smartuni/riot-po-2026/server/frontend/docs/README.md

# SenseMate Frontend

> **Reliable IoT (RIOT) Team — PO-2026**  
> A university project for intelligent flood disaster management

Welcome to the frontend documentation for **SenseMate**, the dashboard and control interface for an IoT-based flood gate management system. This documentation covers the architecture, technology choices, data flows, and design decisions of the React application.

## Quick Links

- [Project Overview](overview.md)
- [Tech Stack](techstack.md)
- [Architecture](architecture.md)
- [Pages & Routing](routing.md)
- [Authentication Flow](authentication.md)
- [Real-Time Communication](real-time.md)
- [Data Flow Patterns](data-flow.md)
- [Build & Deployment](deployment.md)
- [Developer Snippets](snippets.md)
