smartuni/riot-po-2026/nodes/firmware/applications/senseGate/README.md

# SenseGate

### Description
This Module provides the SenseGate Application which detects the status (open/close) of a flood gate. 

### Startup and operation

Pins:
Sensor needs to be connected to: Grnd / A5

- Connect to Power
- Wait until blue LED is on
- Red LED indicates if door is open (LED off) or closed (LED on)
- Blue LED indicates, if a state update is in progress (LED off). 
- There is a time runoff, which is triggered/restarted on any sensor input. When blue LED is on, the update is processed and sent via LoraWAN.    

### Deployment

After flashing, use the [identity-manager](../../identity-manager/README.md) to generate a node identity and provision it to the node.

#### Building and Flashing

```make all flash```
