smartuni/riot-po-2026/nodes/hardware/SenseMate/SenseMatePCB/SenseMate_v2/Parts_Material/SenseMate_Infos.txt

Seeed Studio XIAO nRF52840 Sense Plus
-> Sensoren
https://wiki.seeedstudio.com/XIAO_BLE/
https://www.seeedstudio.com/Seeed-Studio-XIAO-nRF52840-Sense-Plus-p-6360.html

LoRa1276-C1-915
https://www.nicerf.com/lora-module/sx1276-lora-module-lora1276-c1.html

-> https://www.snapeda.com/parts/RFM95W-868S2/RF%20Solutions/view-part/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

-

https://www.lcsc.com/product-detail/C7279189.html
