smartuni/riot-po-2026/documentation/material/Backend-View.png

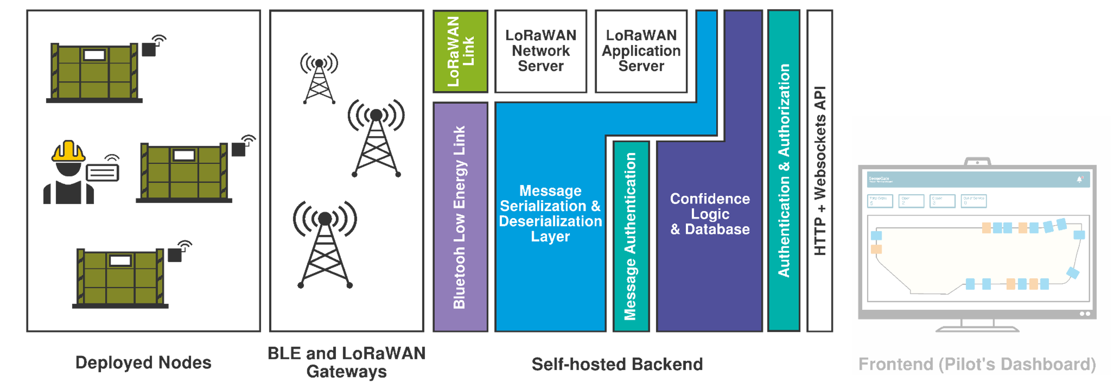
documentation/material/Backend-View.png
