smartuni/riot-po-2026/documentation/material/businesscontextView.png

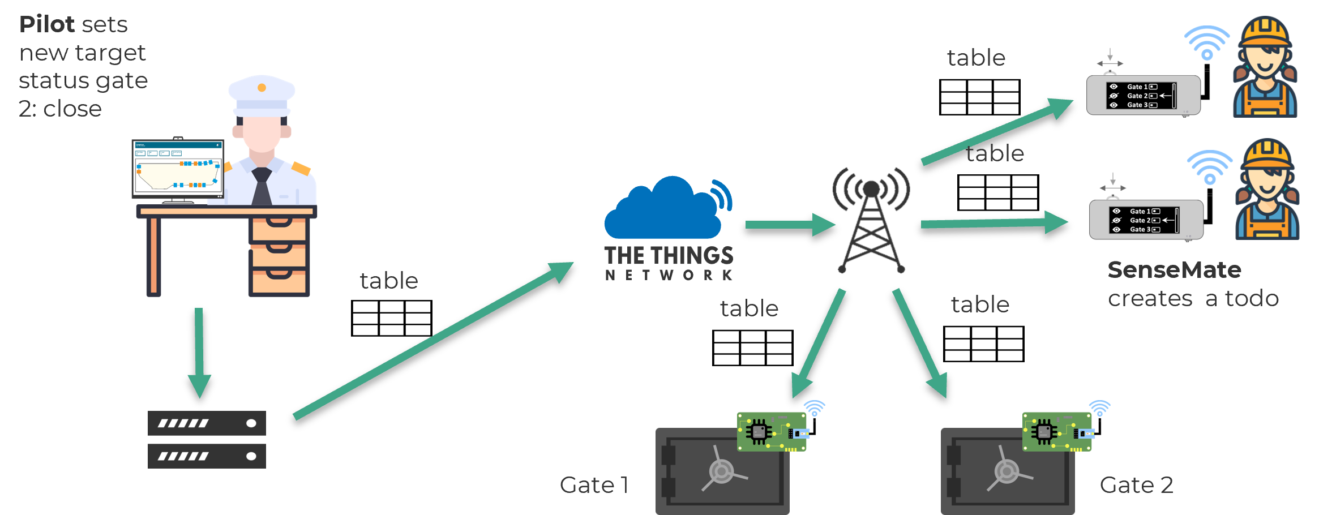
documentation/material/businesscontextView.png
