smartuni/riot-po-2026/documentation/material/technicalView-keys.png

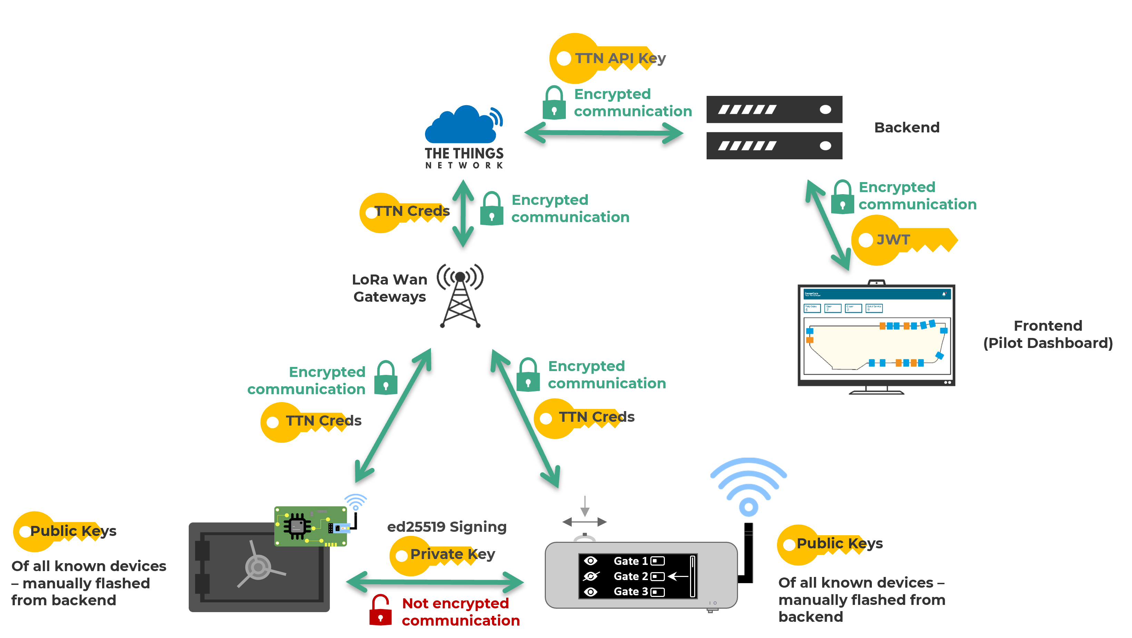
documentation/material/technicalView-keys.png
