smartuni/riot-po-2026/documentation/material/technicalView.png

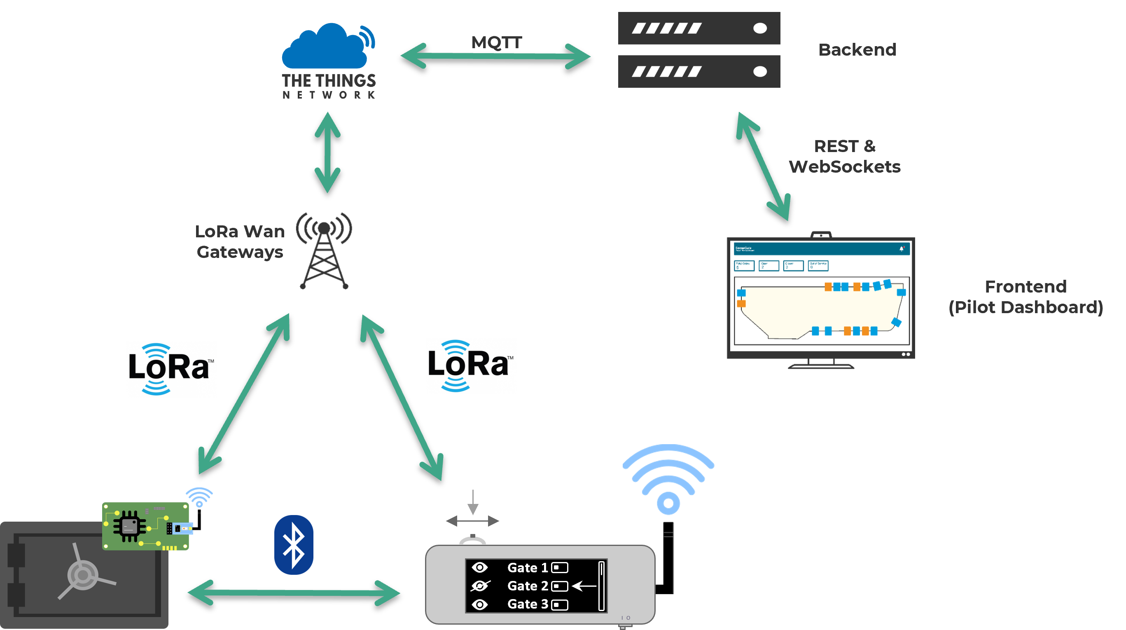
documentation/material/technicalView.png
