smartuni/riot-po-2026/nodes/hardware/SenseMate/SenseMatePCB/SenseMate_v2/Parts_Material/Material_LoRa127X-C1/2412211KGQJ.webp

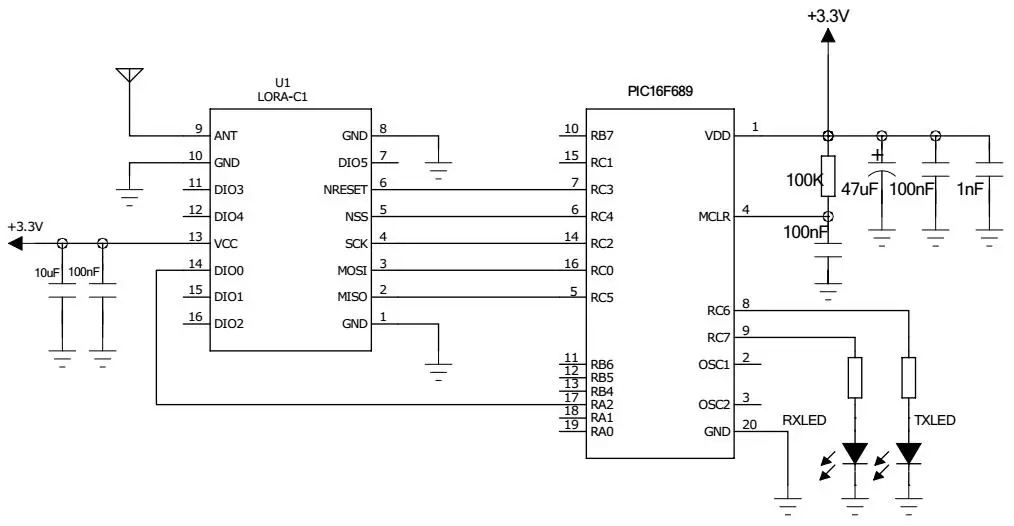
nodes/hardware/SenseMate/SenseMatePCB/SenseMate_v2/Parts_Material/Material_LoRa127X-C1/2412211KGQJ.webp
