smartuni/riot-po-2026/nodes/hardware/SenseMate/SenseMatePCB/SenseMate_v2/Parts_Material/Material_nRF52840SensePlus/4-102010694-seeedstudio-xiao-nrf52840-sense-plus-back_1.jpg

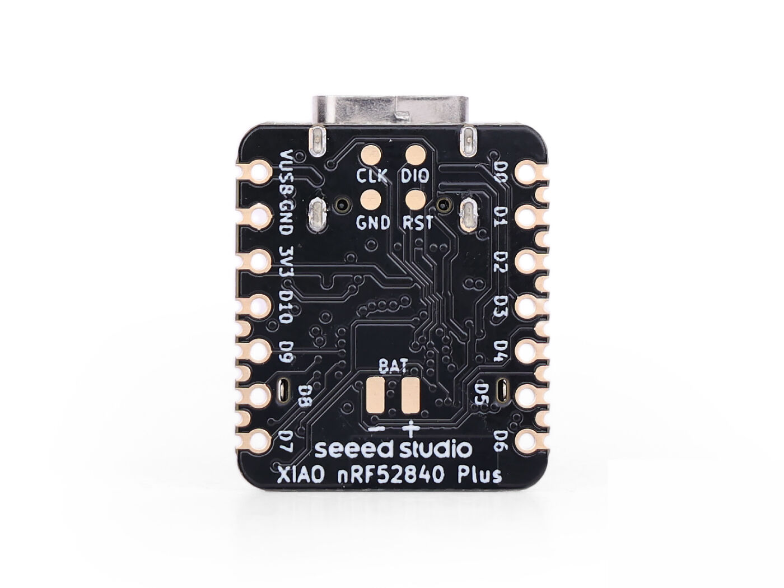
nodes/hardware/SenseMate/SenseMatePCB/SenseMate_v2/Parts_Material/Material_nRF52840SensePlus/4-102010694-seeedstudio-xiao-nrf52840-sense-plus-back_1.jpg
