smartuni/riot-po-2026/nodes/hardware/SenseMate/SenseMatePCB/SenseMate_v2/Parts_Material/Material_nRF52840SensePlus/plus_front.png

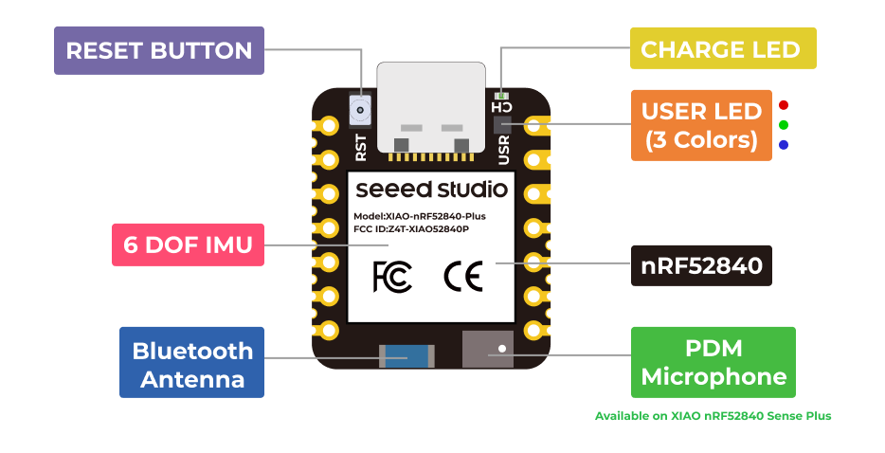
nodes/hardware/SenseMate/SenseMatePCB/SenseMate_v2/Parts_Material/Material_nRF52840SensePlus/plus_front.png
