smartuni/riot-po-2026/nodes/hardware/SenseMate/SenseMatePCB/SenseMate_v2/3dshapes/seeeduino-xiao-samd21-v4.step

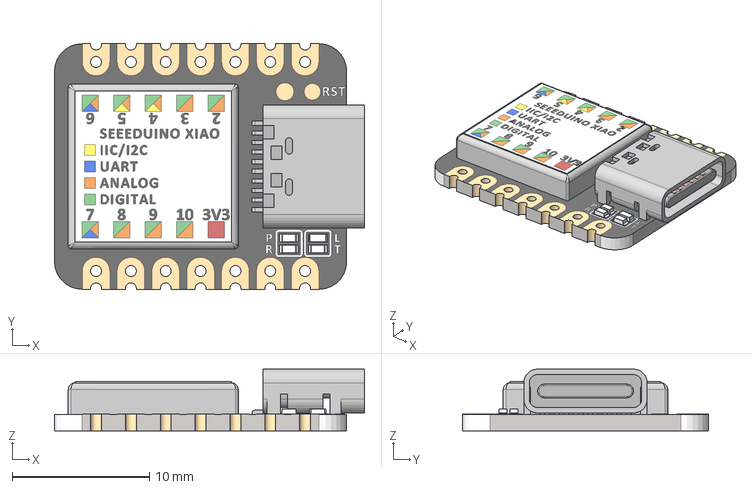
[picture p13: CAD file, 2026-07-06]
nodes/hardware/SenseMate/SenseMatePCB/SenseMate_v2/3dshapes/seeeduino-xiao-samd21-v4.step
22.6 x 17.9 x 4.51 mm
