smartuni/riot-po-2026/nodes/hardware/SenseMate/SenseMatePCB/SenseMate_v2/3dshapes/NAV_SWITCH_separate_colors.STEP

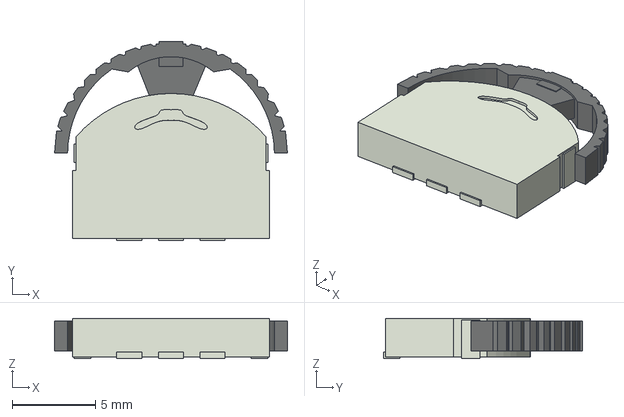
[picture p15: CAD file, 2025-11-07]
nodes/hardware/SenseMate/SenseMatePCB/SenseMate_v2/3dshapes/NAV_SWITCH_separate_colors.STEP
14.0 x 11.9 x 2.40 mm
