smartuni/riot-po-2026/nodes/hardware/SenseMate/SenseMatePCB/SenseMate_v2/3dshapes/4516 Feather nRF52840 Sense_FC_exp.step

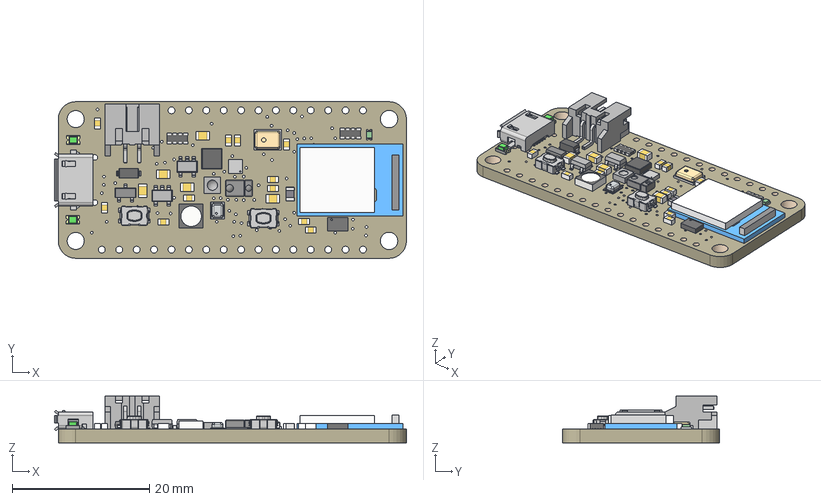
[picture p16: CAD file, 2025-11-07]
nodes/hardware/SenseMate/SenseMatePCB/SenseMate_v2/3dshapes/4516 Feather nRF52840 Sense_FC_exp.step
51.4 x 22.9 x 6.79 mm
JSTPH2
BMP280
SPK0415HM4H
LGA12_2X2MM
LGA16_3X3MM
RESPACK_4X0603 x 2
0805-NO x 5
0603-NO x 11
LED3535
USON8
MDBT50
CHIPLED_0603_NOOUTLINE
_0805MP
SHT3X
SOT23-R
SOD-123
4UCONN_20329_V2
CHIPLED_0805_NOOUTLINE x 2
APDS-9960
SOT23-5 x 2
BTN_KMR2_4.6X2.8 x 2
Board
