smartuni/riot-po-2026/nodes/hardware/SenseMate/SenseMatePCB/SenseMate_v2/3dshapes/3229 Radio FeatherWing.step

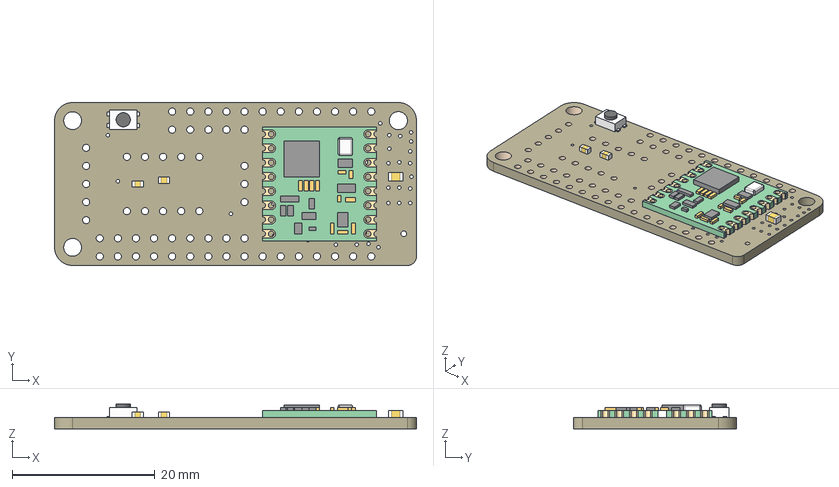
[picture p17: CAD file, 2025-11-07]
nodes/hardware/SenseMate/SenseMatePCB/SenseMate_v2/3dshapes/3229 Radio FeatherWing.step
50.8 x 22.9 x 3.47 mm
Board
BTN_KMR2_4.6X2.8
10uF
RFM69/9x
100k x 2
