smartuni/riot-po-2026/nodes/hardware/SenseMate/SenseMatePCB/SenseMate_v2/3dshapes/SSD1306_OLED_Display(128x64)_trimmed_legs.step

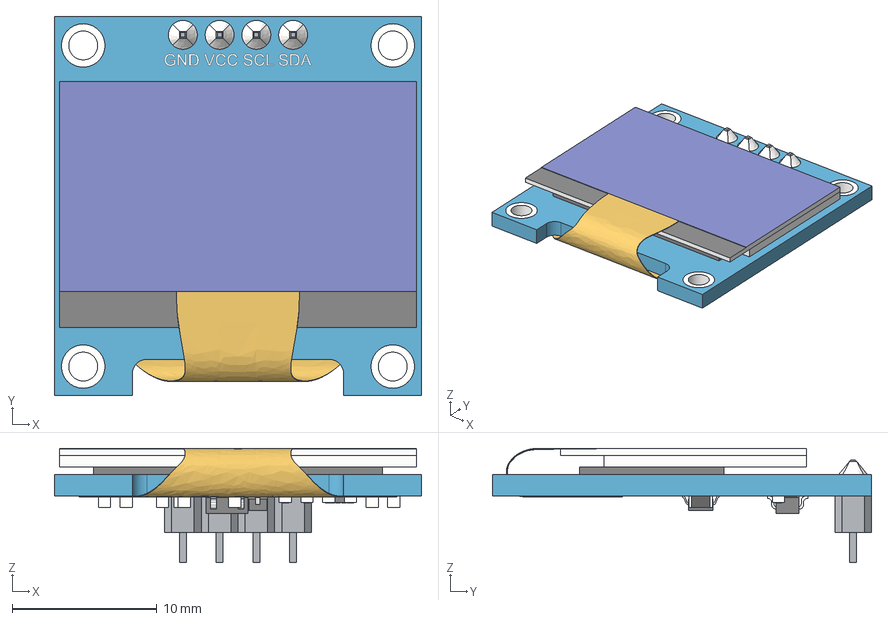
[picture p18: CAD file, 2025-11-07]
nodes/hardware/SenseMate/SenseMatePCB/SenseMate_v2/3dshapes/SSD1306_OLED_Display(128x64)_trimmed_legs.step
25.4 x 26.2 x 7.90 mm
board
board001
board002
board003
board004
board005
board006
board007
board008
screen
screen001
screen002
soldering
soldering001
soldering002
soldering003
smd_capacitor
smd_capacitor001
smd_capacitor002
smd_capacitor (1)
smd_capacitor (1)001
smd_capacitor (1)002
914_smd_resistor
914_smd_resistor001
914_smd_resistor002
472_smd_resistor x 3
472_smd_resistor001 x 3
472_smd_resistor002 x 3
t4_smd_diode
t4_smd_diode001
t4_smd_diode002
smd_capacitor (2)
smd_capacitor (2)001
smd_capacitor (2)002
smd_capacitor (3)
smd_capacitor (3)001
smd_capacitor (3)002
smd_capacitor (4)
smd_capacitor (4)001
smd_capacitor (4)002
smd_capacitor (5)
smd_capacitor (5)001
smd_capacitor (5)002
smd_capacitor (6)
smd_capacitor (6)001
smd_capacitor (6)002
472_smd_resistor (1)
472_smd_resistor (1)001
472_smd_resistor (1)002
SOT-23_XC6206 v3
SOT-23_XC6206 v004
SOT-23_XC6206 v005
SOT-23_XC6206 v006
smd_capacitor (7)
smd_capacitor (7)001
smd_capacitor (7)002
flat_cable
