smartuni/riot-po-2026/nodes/hardware/SenseMate/SenseMatePCB/SenseMate_v2/3dshapes/16-Pin Header - Female - 2.54mm.step

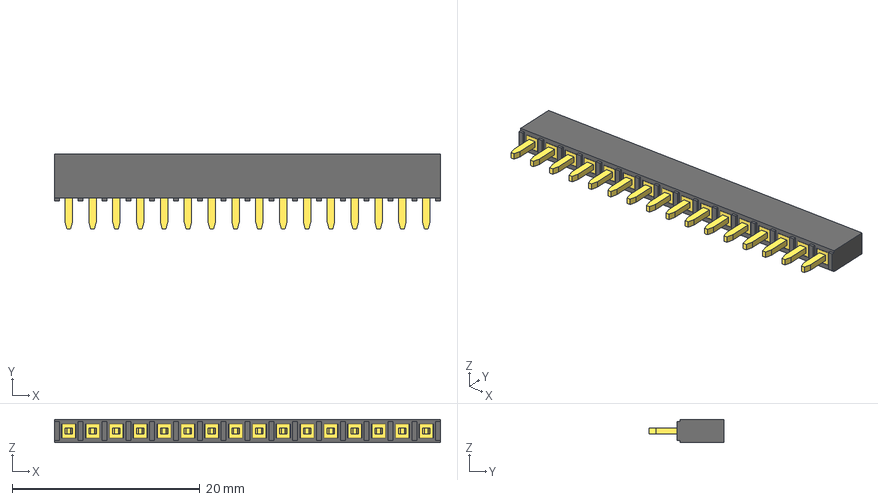
[picture p19: CAD file, 2025-11-07]
nodes/hardware/SenseMate/SenseMatePCB/SenseMate_v2/3dshapes/16-Pin Header - Female - 2.54mm.step
41.1 x 8.00 x 2.50 mm
