smartuni/riot-po-2026/nodes/hardware/SenseMate/SenseMatePCB/SenseMate_v2/3dshapes/12-Pin Header - Female - 2.54mm.step

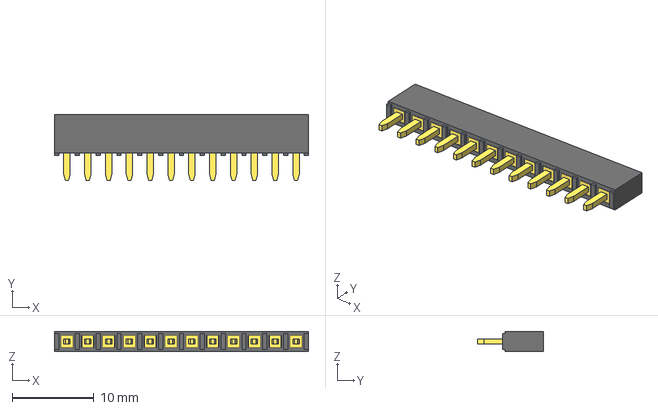
[picture p20: CAD file, 2025-11-07]
nodes/hardware/SenseMate/SenseMatePCB/SenseMate_v2/3dshapes/12-Pin Header - Female - 2.54mm.step
31.0 x 8.00 x 2.50 mm
