smartuni/riot-po-2026/nodes/hardware/SenseMate/SenseMatePCB/SenseMate_v2/3dshapes/PS1240P02BT005_trimmed_legs.step

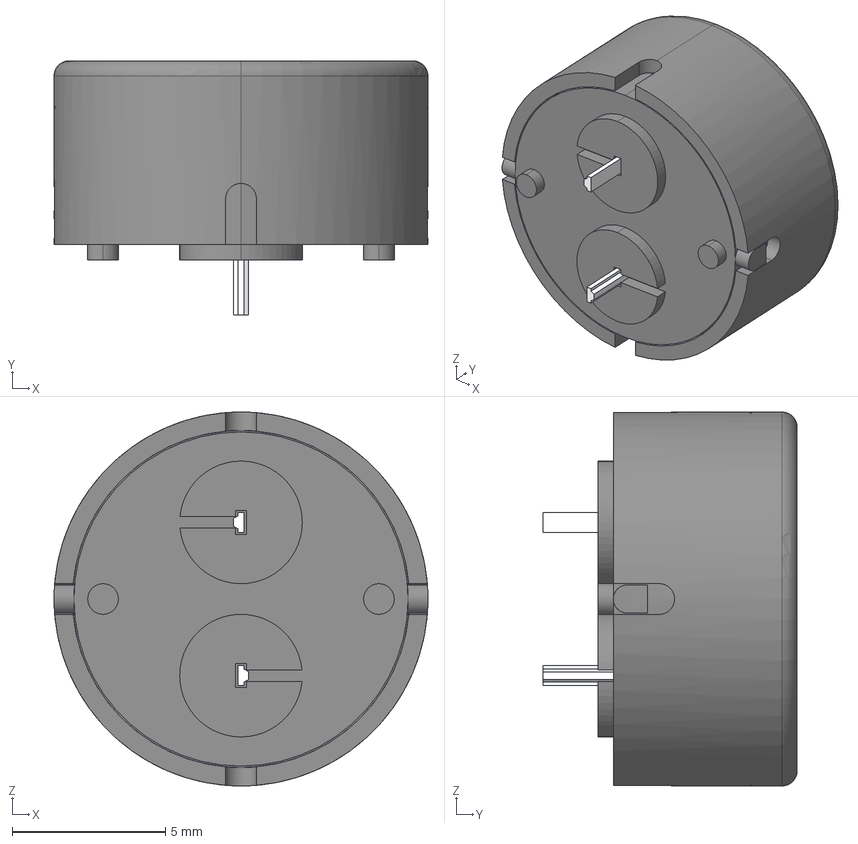
[picture p22: CAD file, 2025-11-07]
nodes/hardware/SenseMate/SenseMatePCB/SenseMate_v2/3dshapes/PS1240P02BT005_trimmed_legs.step
12.2 x 8.30 x 12.2 mm
PS1240P02BT
PS1240P02BT001
PS1240P02BT004
