smartuni/riot-po-2026/nodes/hardware/SenseMate/SenseMatePCB/SenseMate_v2/3dshapes/PS1240P02BT.STEP

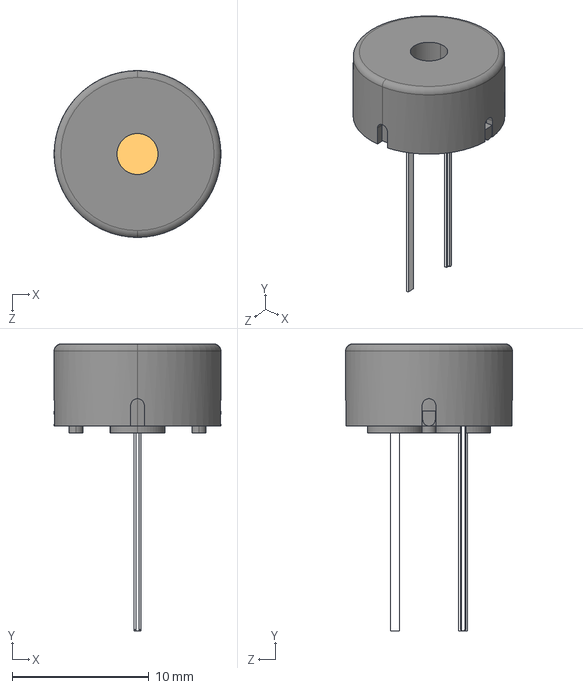
[picture p23: CAD file, 2025-11-07]
nodes/hardware/SenseMate/SenseMatePCB/SenseMate_v2/3dshapes/PS1240P02BT.STEP
12.2 x 21.0 x 12.2 mm
