smartuni/riot-po-2026/nodes/hardware/SenseMate/SenseMatePCB/SenseMate_v2/3dshapes/OS102011MA1QN1.STEP

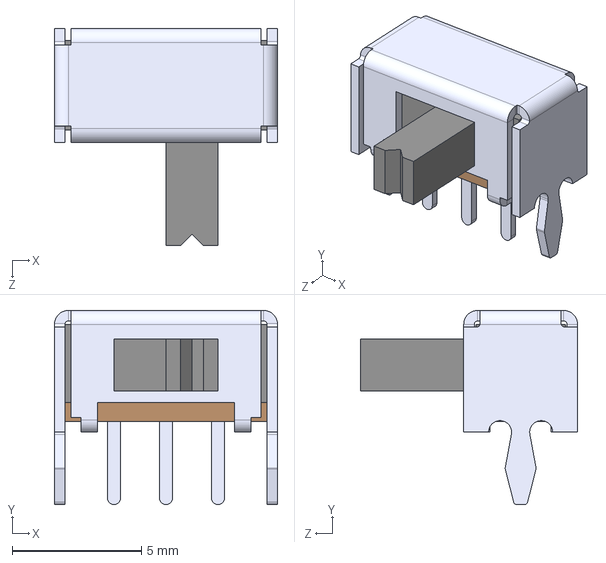
[picture p24: CAD file, 2025-11-07]
nodes/hardware/SenseMate/SenseMatePCB/SenseMate_v2/3dshapes/OS102011MA1QN1.STEP
8.61 x 7.49 x 8.38 mm
