smartuni/riot-po-2026/(list of files, cad)

Other CAD files:
nodes/hardware/SenseMate/SenseMatePCB/SenseMate_v2/3dshapes/NAV_SWITCH_FC_edit-Part.step
nodes/hardware/SenseMate/SenseMatePCB/SenseMate_v2/3dshapes/NAV_SWITCH.STEP
nodes/hardware/SenseMate/SenseMatePCB/SenseMate_v2/3dshapes/4516 Feather nRF52840 Sense.step
nodes/hardware/SenseMate/SenseMatePCB/SenseMate_v1/3dshapes/4516 Feather nRF52840 Sense.step
nodes/hardware/SenseMate/SenseMatePCB/SenseMate_v1/3dshapes/4516 Feather nRF52840 Sense_FC_exp.stl
nodes/hardware/SenseMate/SenseMatePCB/SenseMate_v1/3dshapes/4516_Feather_nRF52840_Sense.step
nodes/hardware/SenseMate/SenseMatePCB/SenseMate_v1/3dshapes/NAV_SWITCH.STEP
nodes/hardware/SenseMate/SenseMatePCB/SenseMate_v1/3dshapes/NAV_SWITCH_FC_edit-Part.step
nodes/hardware/SenseMate/SenseMatePCB/SenseMate_v2/3dshapes/4516 Feather nRF52840 Sense_FC_exp.stl
nodes/hardware/SenseMate/SenseMatePCB/SenseMate_v2/3dshapes/4516_Feather_nRF52840_Sense.step
