smartuni/riot-po-2026/nodes/hardware/SenseGate/SenseGatePCB/sensegate_pcb.kicad_pcb

## KiCad design nodes/hardware/SenseGate/SenseGatePCB/sensegate_pcb.kicad_pcb (2026-07-09)

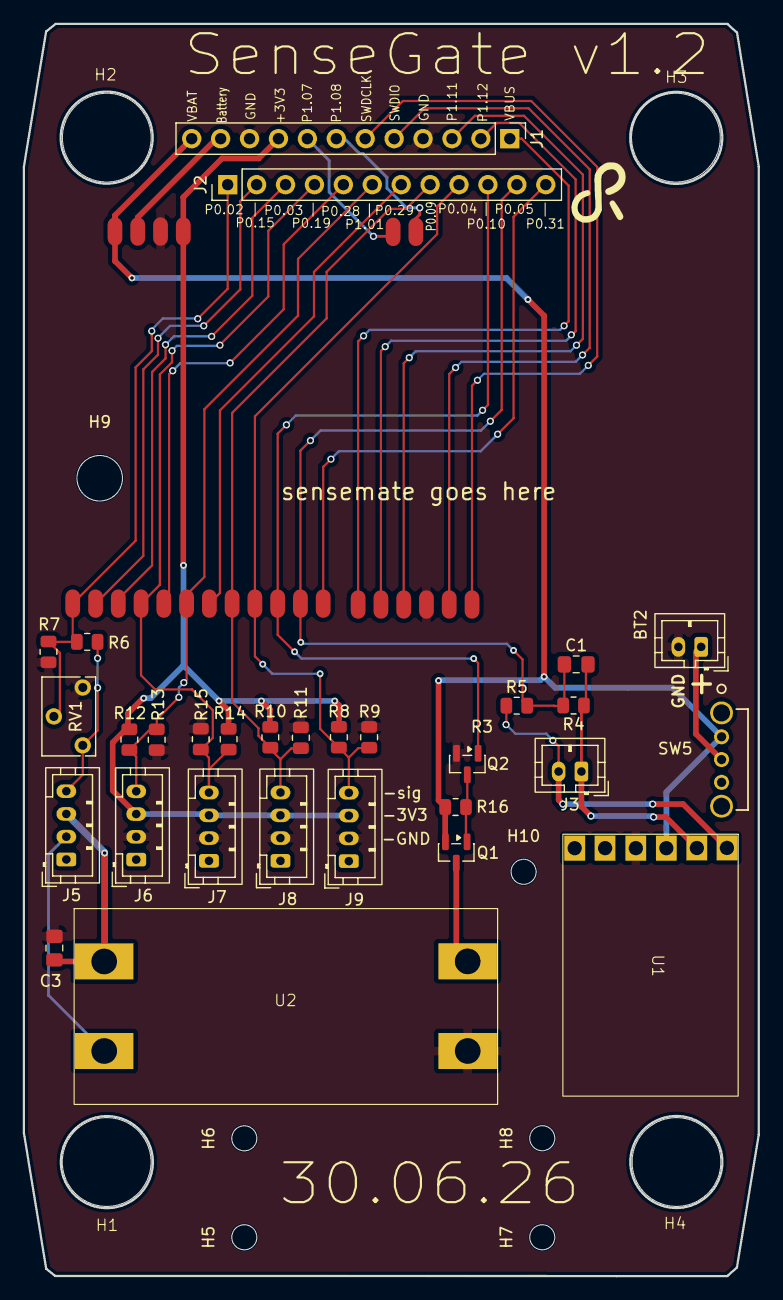
[picture p25: board sensegate_pcb.kicad_pcb from above]

Board: 2 copper layers, 64.6 x 110.0 mm, 41 parts (0 on the bottom side), 31 nets.

Parts:
BT2: Battery; JST_PH_B2B-PH-K_1x02_P2.00mm_Vertical
C1, C3: C; C_0805_2012Metric_Pad1.18x1.45mm_HandSolder
H1, H2, H3, H4: MountingHole; mounting_hole_7.8mm
H5, H6, H7, H8, H10: MountingHole; MountingHole_2.2mm_M2
H9: MountingHole; MountingHole_4mm
J1, J2: Conn_01x12_Pin; PinHeader_1x12_P2.54mm_Vertical
J3: Conn_01x02_Socket; JST_PH_B2B-PH-K_1x02_P2.00mm_Vertical
J4: Conn_01x24_Pin; SenseMateInterface
J5, J6, J7, J8, J9: Conn_01x04_Socket; JST_PH_B4B-PH-K_1x04_P2.00mm_Vertical
Q1: AO3401A; SOT-23
Q2: BSS138; SOT-23
R4, R5, R6, R7, R8, R9, R10, R11, R12, R13, R14, R15, R16: R; R_0805_2012Metric
RV1: R_Potentiometer; Potentiometer_Bourns_3266W_Vertical
SW5: SW_DPDT_x2; OS102011MA1QN1
U1: DD05CVSA
U2: mt3608_dcdc_converter; MT3608_solarbotics

Connections:
20V: C3.2, J5.3, U2.1 (VOUT+)
+3V3: J1.9, J4.+3V3 (Pin_21), J6.3, J7.3, J8.3, J9.3, R8.1, R10.1, R12.1, R14.1
GND: BT2.2 (-), C3.1, J1.4, J1.10, J4.GND (Pin_16), J6.2, J7.2, J8.2, J9.2, Q2.2 (S), R7.1, R9.2, R11.2, R13.2, R15.2, RV1.3, U1.4 (GND(bat-)), U2.4 (VIN-)
GND_IS: J5.2, U2.2 (VOUT-)
IS_ADC: J2.1, J4.P0.02_A0_D0_/_BUZ_EN (Pin_1), R6.1, R7.2, RV1.2
MON_SOLAR: C1.1, J2.11, J4.P0.05_A5_D5_/_SCL (Pin_11), R4.2, R5.2
unnamed: BT2.1 (+), SW5.2 (B)
unnamed: J1.1, J4.VBUS_/_pogo_vbus (Pin_13)
unnamed: J1.2, J4.P1.12_D7_/_pogo_rx (Pin_14)
unnamed: J1.3, J4.P1.11_D6_/_pogo_tx (Pin_15)
unnamed: J1.5, J4.SWDIO_/_pogo_swdio (Pin_17)
unnamed: J1.6, J4.SWDCLK_/_pogo_swdclk (Pin_18)
unnamed: J1.7, J4.P1.05_D18_/_spi_mis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 (Pin_19)
unnamed: J1.8, J4.P1.07_D19_/_spi_mos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 (Pin_20)
unnamed: J1.11, J4.Battery (Pin_23)
unnamed: J2.2, J4.P0.15_D11_/_lora_di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 (Pin_2)
unnamed: J2.3, J4.P0.03_A1_D1_/_lora_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 (Pin_3)
unnamed: J2.5, J4.P0.28_A2_D2_/_lora_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 (Pin_5)
unnamed: J2.7, J4.P0.29_A3_D3_/_lora_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 (Pin_7)
unnamed: J2.12, J4.P0.31_D16 (Pin_12)
unnamed: C1.2, J3.1, R4.1, U1.2 (GND)
unnamed: J3.2, R5.1, U1.1 (VIN)
unnamed: J5.4, R6.2, RV1.1
unnamed: Q1.3 (D), U2.3 (VIN+)
unnamed: Q1.1 (G), Q2.3 (D), R16.1
TOG_20V: J2.10, J4.P0.10_D15_/_VIB_EN (Pin_10), Q2.1 (G)
VBAT: J1.12, J4.VBAT (Pin_24), Q1.2 (S), R16.2, SW5.1 (A), U1.3 (Bat+)
reed_sw_01_measure: J2.8, J4.P0.09_D14_/_TMB2 (Pin_8), J8.4, R10.2, R11.1
reed_sw_02_measure: J2.6, J4.P1.01_D13_/_TMBT1 (Pin_6), J6.4, R12.2, R13.1
reed_sw_03_measure: J2.4, J4.P0.19_D12_/_TMB1 (Pin_4), J7.4, R14.2, R15.1
reed_sw_04_measure: J2.9, J4.P0.04_A4_D4_/_SDA (9), J9.4, R8.2, R9.1
