smartuni/riot-po-2026/nodes/hardware/SenseMate/SenseMatePCB/SenseMate_v2/SenseMatePCB.kicad_pcb

## KiCad design nodes/hardware/SenseMate/SenseMatePCB/SenseMate_v2/SenseMatePCB.kicad_pcb (2026-07-06)

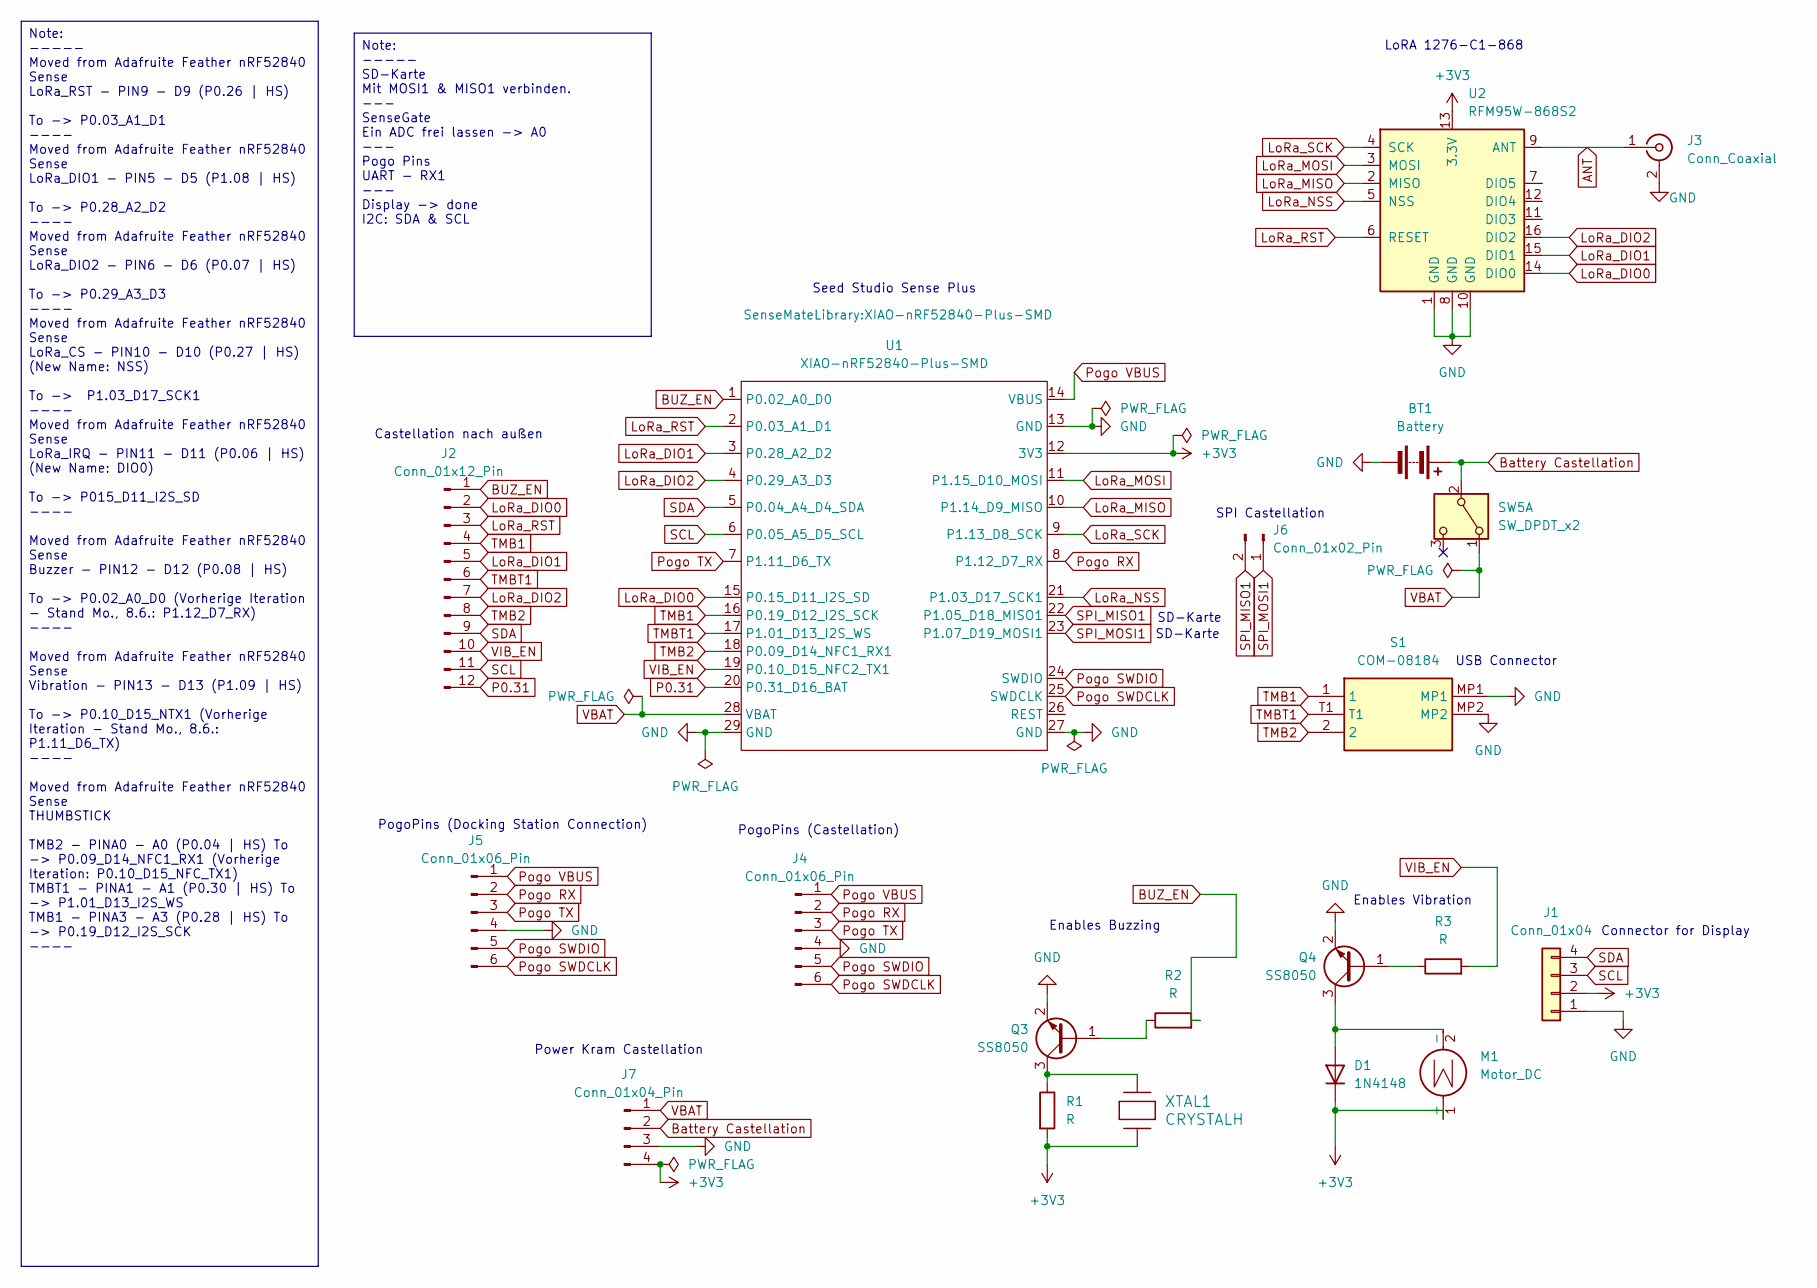
[picture p26: schematic SenseMatePCB.kicad_sch]

Parts:
BT1: Battery; JST_PH_S2B-PH-K_1x02_P2.00mm_Horizontal
D1: 1N4148; D_SOD-323
J1: Conn_01x04; PinHeader_1x04_P2.54mm_Vertical
J2: Conn_01x12_Pin; Castellated_1x12_2.00mm
J3: Conn_Coaxial; U.FL_Molex_MCRF_73412-0110_Vertical
J4: Conn_01x06_Pin; Castellated_1x6_2.00mm
J5: Conn_01x06_Pin; PinHeader_1x06_P2.54mm_Vertical
J6: Conn_01x02_Pin; Castellated_1x2_2.00mm
J7: Conn_01x04_Pin; Castellated_1x4_2.00mm
M1: Motor_DC; PinHeader_1x02_P2.54mm_Vertical
Q3, Q4: SS8050; SOT-23
R1, R2, R3: R; R_0805_2012Metric
S1: COM-08184; COM08184; Manufacturer_Part_Number COM-08184
SW5: SW_DPDT_x2; OS102011MA1QN1
U1: XIAO-nRF52840-Plus-SMD
U2: RFM95W-868S2; HOPERF_RFM9XW_SMD
XTAL1: CRYSTALH; PS1240P02BT

Connections:
+3V3: D1.1 (K), J1.2, J7.4, M1.1 (+), R1.2, U1.12 (3V3), U2.13 (3.3V), XTAL1.1
ANT: J3.1 (In), U2.9 (ANT)
BUZ_EN: J2.1, R2.2, U1.1 (P0.02_A0_D0)
Battery Castellation: BT1.1 (+), J7.2, SW5.2 (B)
GND: BT1.2 (-), J1.1, J3.2 (Ext), J4.4, J5.4, J7.3, Q3.2 (E), Q4.2 (E), S1.MP1, S1.MP2, U1.13 (GND), U1.27 (GND), U1.29 (GND), U2.1 (GND), U2.8 (GND), U2.10 (GND)
LoRa_DIO0: J2.2, U1.15 (P0.15_D11_I2S_SD), U2.14 (DIO0)
LoRa_DIO1: J2.5, U1.3 (P0.28_A2_D2), U2.15 (DIO1)
LoRa_DIO2: J2.7, U1.4 (P0.29_A3_D3), U2.16 (DIO2)
LoRa_MISO: U1.10 (P1.14_D9_MISO), U2.2 (MISO)
LoRa_MOSI: U1.11 (P1.15_D10_MOSI), U2.3 (MOSI)
LoRa_NSS: U1.21 (P1.03_D17_SCK1), U2.5 (NSS)
LoRa_RST: J2.3, U1.2 (P0.03_A1_D1), U2.6 (RESET)
LoRa_SCK: U1.9 (P1.13_D8_SCK), U2.4 (SCK)
unnamed: D1.2 (A), M1.2 (-), Q4.3 (C)
unnamed: Q3.1 (B), R2.1
unnamed: Q3.3 (C), R1.1, XTAL1.2
unnamed: Q4.1 (B), R3.1
P0.31: J2.12, U1.20 (P0.31_D16_BAT)
Pogo RX: J4.2, J5.2, U1.8 (P1.12_D7_RX)
Pogo SWDCLK: J4.6, J5.6, U1.25 (SWDCLK)
Pogo SWDIO: J4.5, J5.5, U1.24 (SWDIO)
Pogo TX: J4.3, J5.3, U1.7 (P1.11_D6_TX)
Pogo VBUS: J4.1, J5.1, U1.14 (VBUS)
SCL: J1.3, J2.11, U1.6 (P0.05_A5_D5_SCL)
SDA: J1.4, J2.9, U1.5 (P0.04_A4_D4_SDA)
SPI_MISO1: J6.2, U1.22 (P1.05_D18_MISO1)
SPI_MOSI1: J6.1, U1.23 (P1.07_D19_MOSI1)
TMB1: J2.4, S1.1, U1.16 (P0.19_D12_I2S_SCK)
TMB2: J2.8, S1.2, U1.18 (P0.09_D14_NFC1_RX1)
TMBT1: J2.6, S1.T1, U1.17 (P1.01_D13_I2S_WS)
VBAT: J7.1, SW5.1 (A), U1.28 (VBAT)
VIB_EN: J2.10, R3.2, U1.19 (P0.10_D15_NFC2_TX1)

Notes on the sheet:
PogoPins (Docking Station Connection)
Seed Studio Sense Plus
SPI Castellation
USB Connector
SD-Karte
Castellation nach außen
Power Kram Castellation
Enables Vibration
LoRA 1276-C1-868
PogoPins (Castellation)
Connector for Display
Enables Buzzing
Note: ----- Moved from Adafruite Feather nRF52840 Sense LoRa_RST - PIN9 - D9 (P0.26 | HS) To -> P0.03_A1_D1 ---- Moved from Adafruite Feather nRF52840 Sense LoRa_DIO1 - PIN5 - D5 (P1.08 | HS) To -> P0.28_A2_D2 ---- Moved from Adafruite Feather nRF52840 Sense LoRa_DIO2 - PIN6 - D6 (P0.07 | HS) To ->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
Note: ----- SD-Karte Mit MOSI1 & MISO1 verbinden. --- SenseGate Ein ADC frei lassen -> A0 --- Pogo Pins UART - RX1 --- Display -> done I2C: SDA & SCL

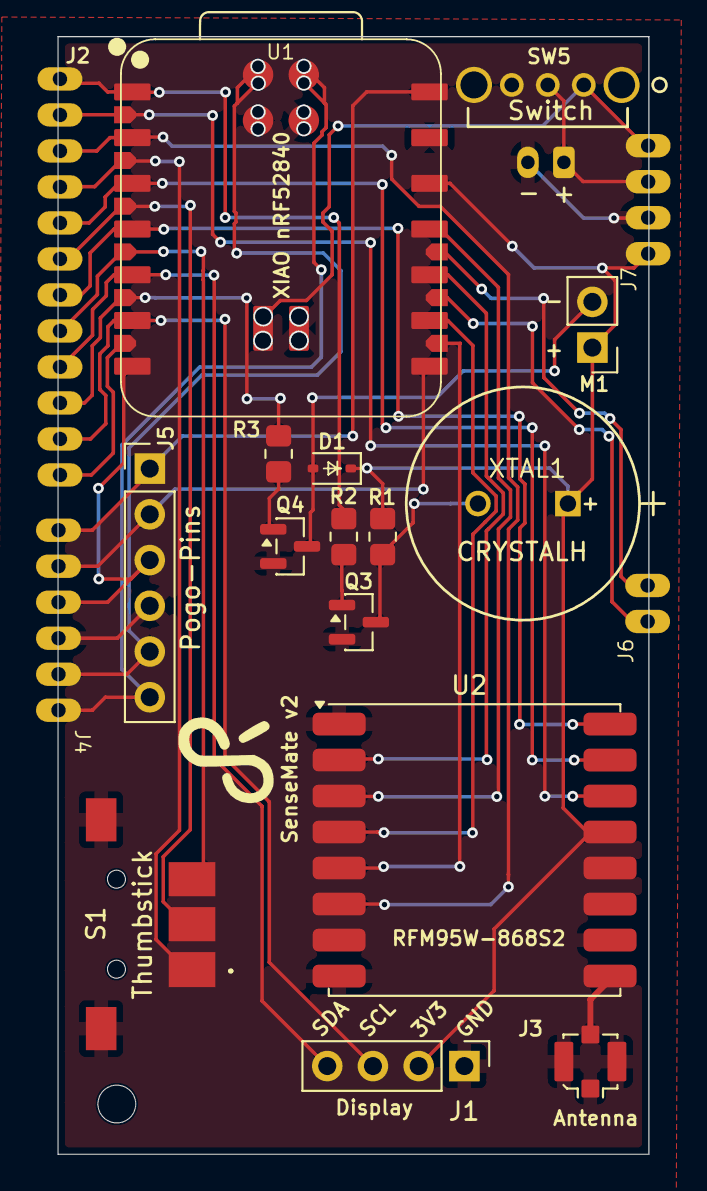
[picture p27: board nodes/hardware/SenseMate/SenseMatePCB/SenseMate_v2/SenseMatePCB.kicad… from above]

Board: 4 copper layers, 32.8 x 62.1 mm, 20 parts (1 on the bottom side), 32 nets.
