smartuni/riot-po-2026/nodes/hardware/SenseMate/SenseMatePCB/SenseMate_v1/SenseMatePCB.kicad_pcb

## KiCad design nodes/hardware/SenseMate/SenseMatePCB/SenseMate_v1/SenseMatePCB.kicad_pcb (2025-11-07, an earlier design)

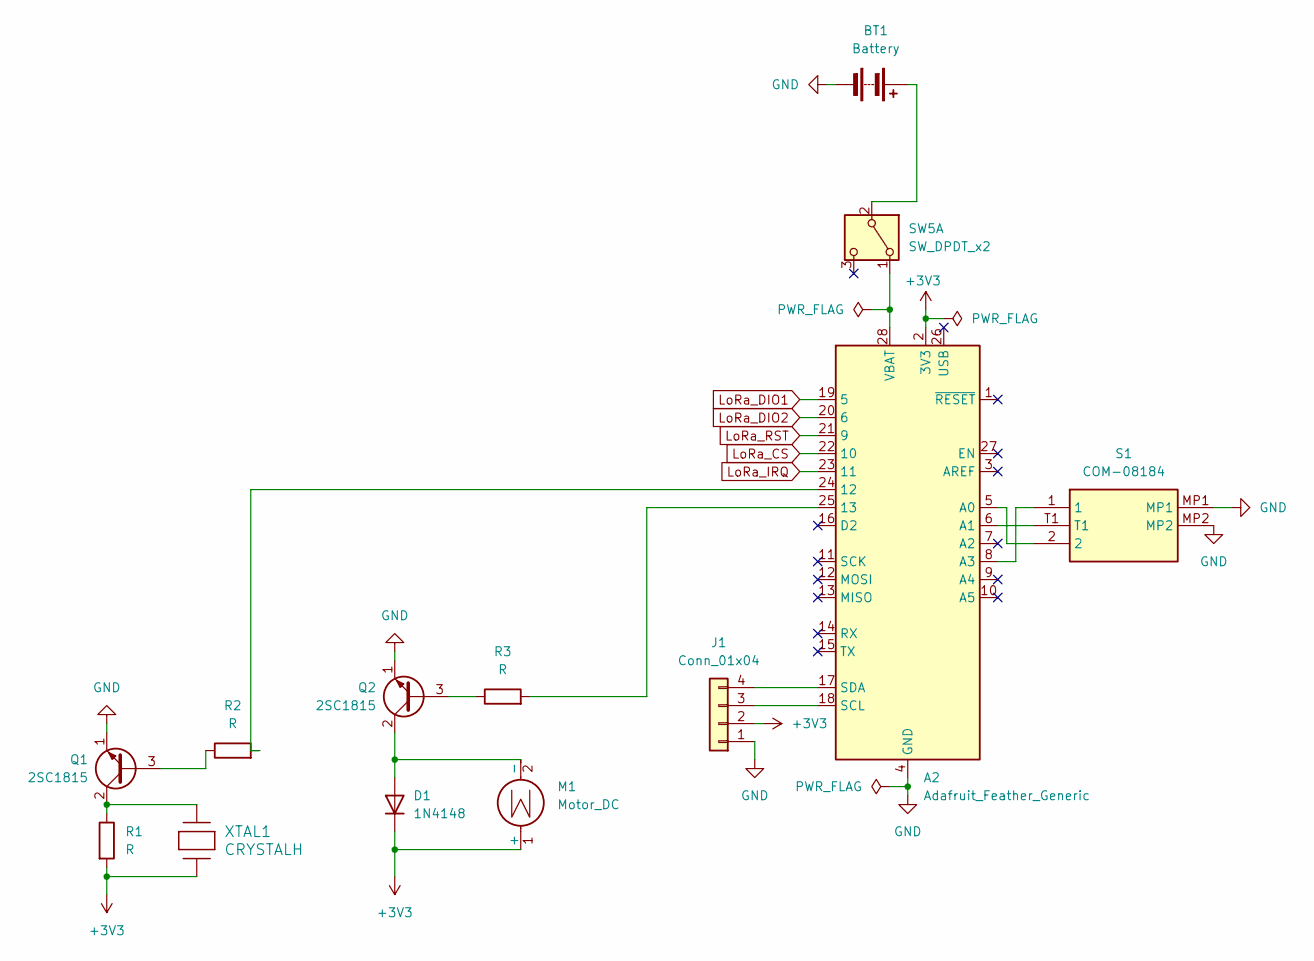
[picture p28: schematic SenseMatePCB.kicad_sch]

Parts:
A2: Adafruit_Feather_Generic; Adafruit_Feather_Sense
BT1: Battery; JST_PH_S2B-PH-K_1x02_P2.00mm_Horizontal
D1: 1N4148; D_SOD-323
J1: Conn_01x04; PinHeader_1x04_P2.54mm_Vertical
M1: Motor_DC; PinHeader_1x02_P2.54mm_Vertical
Q1, Q2: 2SC1815; SOT-23
R1, R2, R3: R; R_0805_2012Metric
S1: COM-08184; COM08184; Manufacturer_Part_Number COM-08184
SW5: SW_DPDT_x2; OS102011MA1QN1
XTAL1: CRYSTALH; XTAL_PS1240P02BT_TDK

Connections:
+3V3: A2.2 (3V3), D1.1 (K), J1.2, M1.1 (+), R1.2, XTAL1.1
GND: A2.4 (GND), BT1.2 (-), J1.1, Q1.1 (E), Q2.1 (E), S1.MP1, S1.MP2
LoRa_CS: A2.22 (10)
LoRa_DIO1: A2.19 (5)
LoRa_DIO2: A2.20 (6)
LoRa_IRQ: A2.23 (11)
LoRa_RST: A2.21 (9)
unnamed: A2.24 (12), R2.2
unnamed: A2.25 (13), R3.2
unnamed: A2.5 (A0), S1.2
unnamed: A2.6 (A1), S1.T1
unnamed: A2.8 (A3), S1.1
unnamed: A2.18 (SCL), J1.3
unnamed: A2.17 (SDA), J1.4
unnamed: A2.28 (VBAT), SW5.1 (A)
unnamed: BT1.1 (+), SW5.2 (B)
unnamed: D1.2 (A), M1.2 (-), Q2.2 (C)
unnamed: Q1.3 (B), R2.1
unnamed: Q1.2 (C), R1.1, XTAL1.2
unnamed: Q2.3 (B), R3.1

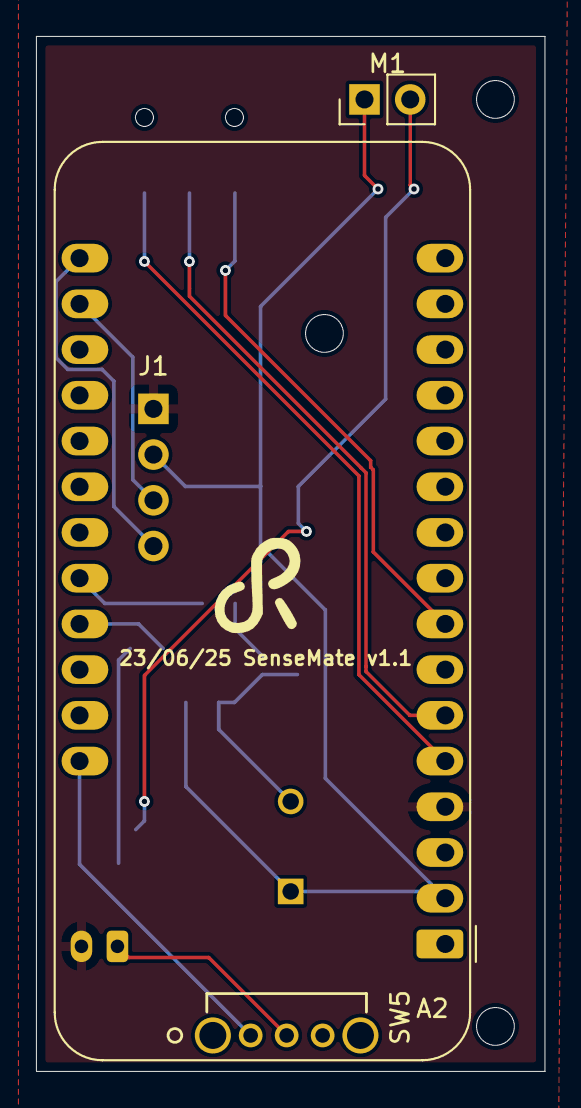
[picture p29: board nodes/hardware/SenseMate/SenseMatePCB/SenseMate_v1/SenseMatePCB.kicad… from above]

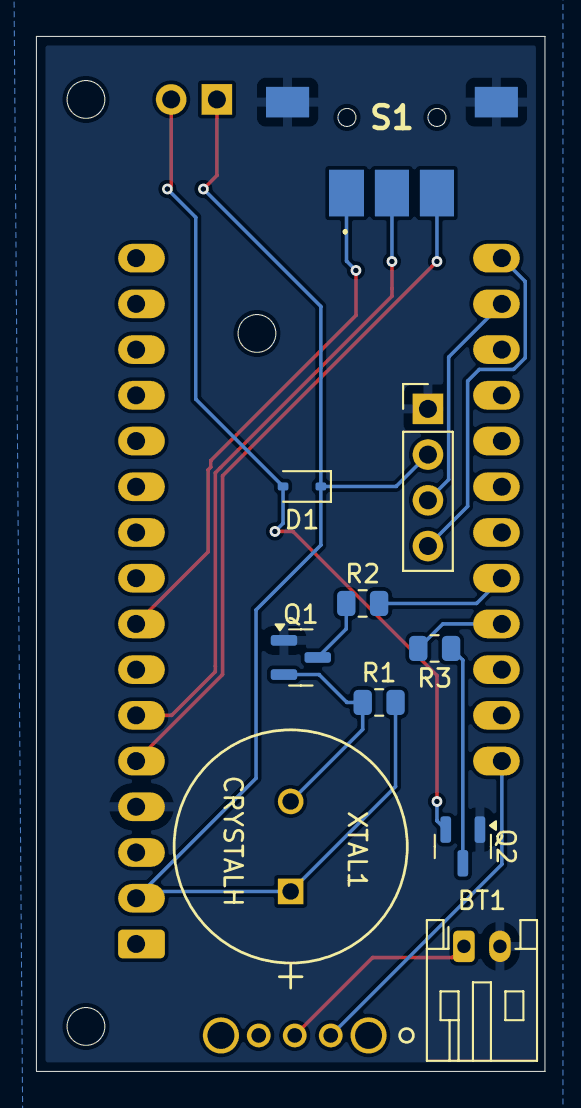
[picture p30: board nodes/hardware/SenseMate/SenseMatePCB/SenseMate_v1/SenseMatePCB.kicad… from below]

Board: 2 copper layers, 28.2 x 57.5 mm, 13 parts (10 on the bottom side), 15 nets.
