smartuni/riot-po-2026/nodes/firmware/applications/senseGate/main.c

#include <stdio.h>
#include <stdlib.h>

#include "od.h"
#include "board.h"
#include "ztimer.h"
#include "thread.h"
#include "tables.h"
#include "tables/records.h"
#include "mate_lorawan.h"
#include "mate_ble.h"
#include "event/thread.h"
#include "inductive_sensor.h"
#include "include/gate_observer.h"
#include "mtd.h"
#include "identity_store.h"
#define LOG_LEVEL   LOG_DEBUG
#include "log.h"
#define _LOGDBG(...) LOG_DEBUG("[main]: " __VA_ARGS__)

#include "personalization.h"
#define MAX_SIGNATURE_SIZE 80
#define MAX_SERIALIZED_RECORD_SIZE 128

static const char *ok(bool condition)
{
    return condition ? "[OK]" : "[ERROR]";
}

#define STORAGE_RAM_MOUNT_PATH "/ram0"
//#define STORAGE_MOUNT_PATH STORAGE_RAM_MOUNT_PATH

#if IS_USED(MODULE_FLASHDB_MTD)
#define STORAGE_MOUNT_PATH ""
#else
#define STORAGE_MOUNT_PATH STORAGE_RAM_MOUNT_PATH
#endif

extern int credential_manager_setup(const char *db_path);
extern int tables_setup(tables_context_t **t, const char *db_path);
extern int storage_setup_ram_mtd(const char *mount_path);
tables_context_t *tables;

#define TIME_PERIOD_TABLE_UPDATE 30 // const defines time to update table periodically
//#define TIME_PERIOD_TABLE_UPDATE 2 // const defines time to update table periodically

#if defined BOARD_ADAFRUIT_FEATHER_NRF52840_SENSE // v1 board
/* PIN label on feather sense: "A1" */
#define REED_0_PIN_0 GPIO_PIN(0, 5)
#elif defined BOARD_SEEEDSTUDIO_XIAO_NRF52840_SENSE // v2 board
#define REED_0_PIN_0 GPIO_PIN(0, 9)
#else
#error "Missing board-specific configuration."
#endif

#define INDUCTIVE_SENSOR_DCDC_PWR_PIN GPIO_PIN(0,4)
#define INDUCTIVE_SENSOR_DCDC_PWR_PIN_AH (false)
#define INDUCTIVE_SENSOR_ADC_LINE (4)
#define INDUCTIVE_SENSOR_ADC_VREF_MV (3300)
#define INDUCTIVE_SENSOR_VREF_MV     (11000)

static kernel_pid_t ble_tx_pid = KERNEL_PID_UNDEF;

#include "shell.h"
char shell_stack[2*THREAD_STACKSIZE_DEFAULT];
void* shell_thread(void* arg)
{
    (void)arg;
    char line_buf[SHELL_DEFAULT_BUFSIZE];
    shell_run(NULL, line_buf, SHELL_DEFAULT_BUFSIZE);

    return 0;
}

inductive_sensor_t inductive_sensor;

uint32_t inductive_sensor_measure_cb(void *ctx)
{
    inductive_sensor_t *is = (inductive_sensor_t*)ctx;
    inductive_sensor_power(is, true);
    ztimer_sleep(ZTIMER_MSEC, 50);
    uint32_t sum = 0;
    unsigned nsamples = 16;
    for (unsigned i = 0; i < nsamples; i++) {
       sum += inductive_sensor_sample(&inductive_sensor);
    }
    inductive_sensor_power(is, false);

    uint32_t avg = sum / nsamples;
    return inductive_sensor_sample2adc_voltage(is, avg);
}

gate_observer_t observer = {
    .config = {
        .limit_switch_confs = {
                                { .pin = REED_0_PIN_0,
                                  .pull_conf = GPIO_IN,
                                  .closed_level = false }
                              },
    },
};

void gate_observer_state_change_cb(gate_state_t new_state)
{
    _LOGDBG("%s new state = %s\n", __func__, gate_state_tostr(new_state));
    int res = tables_put_gate_report(tables, new_state);
    _LOGDBG("%s tables_put_gate_report %s\n", __func__, ok(res == 0));
    // if ble-mate is ready to receive messages
    if (ble_tx_pid != KERNEL_PID_UNDEF) {
        table_query_t *q = malloc(sizeof(table_query_t));
        if (q) {
            tables_init_query(q, RECORD_GATE_REPORT, &self_node_id, NULL);
            msg_t m = { .type = MATE_BLE_TX_QUERY_MATCHES_MSG_TYPE,
                        .content.ptr = q };
            msg_send(&m, ble_tx_pid);
        }
    }
}

static void _table_update_cb(tables_context_t *ctx, const table_record_t *record,
                             const table_query_t *query, void *arg)
{
    (void)ctx;
    (void)arg;
    (void)query;
    if (LOG_LEVEL >= LOG_DEBUG) {
        char record_str[TABLE_RECORD_STRING_SIZE];
        record_tostr(record, record_str, sizeof(record_str));
        _LOGDBG("UPDT: %s\n", record_str);
    }

    // don't unconditionally trigger TX here.
    // The change may aswell come from a recent RX.
}


int main(void){
    /* Sleep so that we do not miss this message while connecting */
    ztimer_sleep(ZTIMER_SEC, 3);
    puts("[main]: starting");

    int res = identity_store_init();
    _LOGDBG("identity_store_init: %s\n", ok(res == 0));

    res = get_own_node_id(self_node_id, sizeof(self_node_id));
    _LOGDBG("get_own_node_id: %s\n", ok(res == 0));

    thread_create(
        shell_stack,
        sizeof(shell_stack),
        THREAD_PRIORITY_MAIN - 2,
        THREAD_CREATE_STACKTEST,
        shell_thread,
        NULL,
       "shell"
    );

    res = storage_setup_ram_mtd(STORAGE_MOUNT_PATH);
    _LOGDBG("storage_setup_ram_mtd: %s\n", ok(res == 0));

    res = credential_manager_setup(STORAGE_MOUNT_PATH "/cred");
    _LOGDBG("credential_manager_setup: %s\n", ok(res == 0));

    res = tables_setup(&tables, STORAGE_MOUNT_PATH "/tables");
    _LOGDBG("tables_setup: %s\n", ok(res == 0));

    table_memo_t memo;
    table_query_t query;

    void *cb_arg = 0;
    tables_init_query(&query, RECORD_GATE_REPORT, NULL, NULL);
    tables_add_memo(tables, &memo, &query, _table_update_cb, cb_arg);

    res = gate_observer_init(&observer, &observer.config, gate_observer_state_change_cb);
    _LOGDBG("gate_observer_init %s\n", ok(res == 0));

    _LOGDBG("reading initial door state\n");
    gate_observer_state_t obs_state;
    gate_state_t initial_gate_state = gate_observer_get_state(&observer, &obs_state);

    for (int i = 0; i < GATE_OBSERVER_LIMITSWITCH_SENSOR_CNT; i++) {
        _LOGDBG("limit switch[%d]: %s\n", i, obs_state.ls_states[i] == LIMIT_SWITCH_ENGAGED ? "CLOSED" : "OPEN");
    }

    for (int i = 0; i < GATE_OBSERVER_DISTANCE_SENSOR_CNT; i++) {
        uint32_t distance = obs_state.distances[i];
        _LOGDBG("distance[%d]: %lu\n", i, distance);
    }

    _LOGDBG("initial gate state: %s\n",
            initial_gate_state == GATE_STATE_CLOSED ? "CLOSED" :
            (initial_gate_state == GATE_STATE_OPEN ? "OPEN" : "INVALID"));

    _LOGDBG("put initial state to tables...\n");
    res = tables_put_gate_report(tables, initial_gate_state);
    _LOGDBG("put initial gate report %s\n", ok(res == 0));

    // start lorawan
    _LOGDBG("starting lorawan...\n");
    int lorawanstarted = mate_lorawan_start(tables);
    if (-1 == lorawanstarted){
        _LOGDBG("starting lorawan failed\n");
    }

    //start thread init bluetooth
    _LOGDBG("starting [mate_ble]\n");
    if (BLE_SUCCESS == mate_ble_init(tables, &ble_tx_pid)){
        _LOGDBG("[mate_ble] init complete\n");
    } else {
        _LOGDBG("[mate_ble] not started\n");
    }

    int timeToUpdateTable = 0; // var to update table periodically
    int put_cnt = 0;
    int put_err_cnt = 0;
    while(1){
        ztimer_sleep(ZTIMER_MSEC,1000);

        if (timeToUpdateTable == TIME_PERIOD_TABLE_UPDATE) {
            _LOGDBG("get current observer state...\n");
            gate_state_t current_gate_state = gate_observer_get_state(&observer, &obs_state);
            _LOGDBG("current state: %s\n", gate_state_tostr(current_gate_state));
            _LOGDBG("put new reported state...\n");
            res = tables_put_gate_report(tables, current_gate_state);
            _LOGDBG("tables_put_gate_report %s\n", ok(res == 0));
            put_cnt++;
            if (res) {
                put_err_cnt++;
            }
            timeToUpdateTable = 0;
        } else {
            timeToUpdateTable++;
        }
    }

    return 0;
}
