smartuni/riot-po-2026/server/backend/src/main/java/com/riot/matesense/service/AuthService.java

package com.riot.matesense.service;

import com.riot.matesense.config.JWTSecretProperties;
import com.riot.matesense.config.TestAccountProperties;
import com.riot.matesense.entity.UserEntity;
import com.riot.matesense.exceptions.InvalidCredentialsException;
import com.riot.matesense.model.AuthRequest;
import com.riot.matesense.model.RegisterRequest;
import com.riot.matesense.model.UserChangeRequest;
import com.riot.matesense.model.UserDetailsResponse;
import com.riot.matesense.repository.UserRepository;

import io.jsonwebtoken.Claims;
import io.jsonwebtoken.Jwts;

import org.springframework.beans.factory.annotation.Autowired;
import org.springframework.stereotype.Service;
import org.springframework.security.crypto.bcrypt.BCryptPasswordEncoder;


import java.security.Key;
import java.util.Date;
import java.util.Map;
import java.util.concurrent.ConcurrentHashMap;

import org.springframework.scheduling.annotation.Scheduled;

import org.slf4j.Logger;
import org.slf4j.LoggerFactory;

@Service
public class AuthService {

    private static final Logger log = LoggerFactory.getLogger(AuthService.class);

    private UserRepository userRepository;
    private final Map<String, Long> tokenStore = new ConcurrentHashMap<>();
    private final Key secretKey; // shared secret with JwtService
    private final BCryptPasswordEncoder passwordEncoder;

    @Autowired
    public AuthService(TestAccountProperties testAccountProperties, UserRepository userRepository,
                       JWTSecretProperties jwtSecretProperties, BCryptPasswordEncoder passwordEncoder) {
        this.userRepository = userRepository;
        this.secretKey = jwtSecretProperties.getKey();
        this.passwordEncoder = passwordEncoder;
        for (TestAccountProperties.Account a : testAccountProperties.getAccounts()) {
            try {
                log.warn("Enabling test user account {} — disable before deployment", a.getEmail());
                // Check if user already exists (from Flyway migration)
                if (userRepository.findByEmail(a.getEmail()) == null) {
                    RegisterRequest rr = new RegisterRequest();
                    rr.setEmail(a.getEmail());
                    rr.setName(a.getUsername());
                    rr.setPassword(a.getPassword());
                    rr.setRole(a.getRole());
                    this.handleRegisterWithoutDuplicate(rr);
                } else {
                    log.info("Test account {} already exists, skipping creation", a.getEmail());
                }
            } catch (RuntimeException e) {
                log.error("Could not create test account {}: {}", a.getEmail(), e.getMessage());
            }
        }
    }

    public String handleLogin(AuthRequest request) {
        UserEntity user = userRepository.findByEmail(request.getEmail());

        if (user == null || !passwordEncoder.matches(request.getPassword(), user.getPassword())) {
            throw new InvalidCredentialsException("Invalid email or password");
        }

        String token = generateToken(user.getId());
        tokenStore.put(token, user.getId());
        // System.out.println("Created Login Token " + token);
        return token;
    }

    public String handleRegister(RegisterRequest request) {
        if (userRepository.findByEmail(request.getEmail()) != null) {
            throw new RuntimeException("Email already in use");
        }
        String hashedPassword = passwordEncoder.encode(request.getPassword());

        UserEntity user = new UserEntity(request.getEmail(), hashedPassword, request.getName(), request.getRole());
        userRepository.save(user);

        String token = generateToken(user.getId());
        tokenStore.put(token, user.getId());
        // System.out.println("Created Register Token " + token);
        return token;
    }

    // Helper method for test account initialization - silently skips if email exists
    private String handleRegisterWithoutDuplicate(RegisterRequest request) {
        UserEntity existingUser = userRepository.findByEmail(request.getEmail());
        if (existingUser != null) {
            // User already exists, skip creation
            String token = generateToken(existingUser.getId());
            tokenStore.put(token, existingUser.getId());
            return token;
        }
        
        String hashedPassword = passwordEncoder.encode(request.getPassword());
        UserEntity user = new UserEntity(request.getEmail(), hashedPassword, request.getName(), request.getRole());
        userRepository.save(user);

        String token = generateToken(user.getId());
        tokenStore.put(token, user.getId());
        return token;
    }

    public void handleLogout(String token) {
        if (token == null) {
            throw new RuntimeException("No token provided");
        }
        tokenStore.remove(token);
    }

    public Long getUserIdFromToken(String token) {
        Claims claims = Jwts.parserBuilder()
                .setSigningKey(secretKey)
                .build()
                .parseClaimsJws(token)
                .getBody();
        return Long.parseLong(claims.getSubject());
    }

    public boolean isTokenInStore(String token) {
        return tokenStore.containsKey(token);
    }

    public UserDetailsResponse getUserDetails(String token) {
        if (token == null) {
            throw new RuntimeException("No token provided");
        }
        Long uId = getUserIdFromToken(token);
        UserEntity user = userRepository.getById(uId);
        if (user == null) {
            throw new RuntimeException("User not found");
        }
        return new UserDetailsResponse(user.getName(), user.getEmail(), user.getRole(), user.getId());
    }

    public void changeUserDetails(UserChangeRequest request, String token) {
        if (token == null) {
            throw new RuntimeException("No token provided");
        }
        Long uId = getUserIdFromToken(token);
        UserEntity user = userRepository.getById(uId);
        if (user == null || !passwordEncoder.matches(request.getPassword(), user.getPassword())) {
            throw new RuntimeException("Invalid credentials");
        }
        if (!user.getName().equals(request.getName())) {
            user.setName(request.getName());
        }
        if (request.getNewPassword() != null && !request.getNewPassword().isBlank()) {
            if (!passwordEncoder.matches(request.getNewPassword(), user.getPassword())) {
                String hashedNewPassword = passwordEncoder.encode(request.getNewPassword());
                user.setPassword(hashedNewPassword);
            }
        }

        userRepository.save(user);
    }

    public String generateToken(Long userId) {
        long expirationMillis = 1000 * 60 * 60 * 10; // 10 hours
        Date now = new Date();
        Date expiryDate = new Date(now.getTime() + expirationMillis);

        return Jwts.builder()
                .setSubject(String.valueOf(userId))
                .setIssuedAt(now)
                .setExpiration(expiryDate)
                .signWith(secretKey)
                .compact();
    }

    // Evict expired tokens every 60 seconds
    @Scheduled(fixedRate = 60_000)
    public void evictExpiredTokens() {
        Date now = new Date();
        int before = tokenStore.size();
        tokenStore.entrySet().removeIf(entry -> {
            try {
                Claims claims = Jwts.parserBuilder()
                        .setSigningKey(secretKey)
                        .build()
                        .parseClaimsJws(entry.getKey())
                        .getBody();
                return claims.getExpiration().before(now);
            } catch (Exception e) {
                // Malformed or invalid token — evict
                return true;
            }
        });
        int removed = before - tokenStore.size();
        if (removed > 0) {
            log.info("Token cleanup: removed {} expired tokens, {} remain", removed, tokenStore.size());
        }
    }
}
