smartuni/riot-po-2026/server/backend/src/main/java/com/riot/matesense/config/SecurityConfig.java

package com.riot.matesense.config;

import jakarta.servlet.http.HttpServletResponse;
import com.riot.matesense.security.JwtAuthenticationFilter;
import org.springframework.context.annotation.Bean;
import org.springframework.context.annotation.Configuration;
import org.springframework.security.config.annotation.method.configuration.EnableMethodSecurity;
import org.springframework.security.config.annotation.web.builders.HttpSecurity;
import org.springframework.security.config.annotation.web.configuration.EnableWebSecurity;
import org.springframework.security.crypto.bcrypt.BCryptPasswordEncoder;
import org.springframework.security.web.SecurityFilterChain;
import org.springframework.security.web.context.SecurityContextHolderFilter;
import org.springframework.security.web.csrf.CookieCsrfTokenRepository;
import org.springframework.security.web.csrf.CsrfTokenRequestAttributeHandler;

@Configuration
@EnableWebSecurity
@EnableMethodSecurity
public class SecurityConfig {

    private final JwtAuthenticationFilter jwtFilter;

    public SecurityConfig(JwtAuthenticationFilter jwtFilter) {
        this.jwtFilter = jwtFilter;
    }

    @Bean
    public SecurityFilterChain securityFilterChain(HttpSecurity http) throws Exception {
        return http
                .cors(cors -> cors.disable())
                .csrf(csrf -> {
                    CookieCsrfTokenRepository tokenRepository = CookieCsrfTokenRepository.withHttpOnlyFalse();
                    CsrfTokenRequestAttributeHandler requestHandler = new CsrfTokenRequestAttributeHandler();
                    requestHandler.setCsrfRequestAttributeName(null);
                    csrf.csrfTokenRepository(tokenRepository)
                        .csrfTokenRequestHandler(requestHandler)
                        .ignoringRequestMatchers("/auth/login", "/auth/logout", "/e2e/**");
                })
                .authorizeHttpRequests(auth -> auth
                    .requestMatchers("/auth/login", "/auth/register", "/auth/logout").permitAll()
                    .requestMatchers("/gates").permitAll()
                    .requestMatchers("/gate-activities").permitAll()
                    .requestMatchers("/health").permitAll()
                    .requestMatchers("/ws/**").permitAll()
                    .requestMatchers("/actuator/health").permitAll()
                    .requestMatchers("/e2e/**").permitAll()
                    .anyRequest().authenticated()
                )
                .addFilterAfter(jwtFilter, SecurityContextHolderFilter.class)
                .exceptionHandling(exception -> exception
                        .authenticationEntryPoint((request, response, authException) -> {
                            response.setStatus(HttpServletResponse.SC_UNAUTHORIZED);
                            response.getWriter().write("Unauthorized");
                        })
                )
                .build();
    }

    @Bean
    public BCryptPasswordEncoder passwordEncoder() {
        return new BCryptPasswordEncoder();
    }
}
