smartuni/riot-po-2026/nodes/firmware/applications/senseMate/sensemate_ui/cnc.c

/*******************************************************************************
 * Size: 12 px
 * Bpp: 1
 * Opts: --bpp 1 --size 12 --no-compress --stride 1 --align 1 --font C&C Red Alert [INET].ttf --range 32-127 --format lvgl -o cnc.c
 ******************************************************************************/

#ifdef __has_include
    #if __has_include("lvgl.h")
        #ifndef LV_LVGL_H_INCLUDE_SIMPLE
            #define LV_LVGL_H_INCLUDE_SIMPLE
        #endif
    #endif
#endif

#ifdef LV_LVGL_H_INCLUDE_SIMPLE
    #include "lvgl.h"
#else
    #include "lvgl/lvgl.h"
#endif



#ifndef CNC
#define CNC 1
#endif

#if CNC

/*-----------------
 *    BITMAPS
 *----------------*/

/*Store the image of the glyphs*/
static LV_ATTRIBUTE_LARGE_CONST const uint8_t glyph_bitmap[] = {
    /* U+0020 " " */
    0x0,

    /* U+0021 "!" */
    0xfa,

    /* U+0022 "\"" */
    0xb4,

    /* U+0023 "#" */
    0x28, 0x53, 0xf9, 0x4f, 0xe5, 0xa, 0x0,

    /* U+0024 "$" */
    0x23, 0xe8, 0xe2, 0xf8, 0x80,

    /* U+0025 "%" */
    0x43, 0x49, 0x20, 0x82, 0x49, 0x61, 0x0,

    /* U+0026 "&" */
    0x4a, 0xa4, 0xba, 0x70,

    /* U+0027 "'" */
    0x78,

    /* U+0028 "(" */
    0x2a, 0x48, 0x88,

    /* U+0029 ")" */
    0x88, 0x92, 0xa0,

    /* U+002A "*" */
    0x48, 0xcf, 0xcc, 0x48,

    /* U+002B "+" */
    0x21, 0x3e, 0x42, 0x0,

    /* U+002C "," */
    0xf8,

    /* U+002D "-" */
    0xe0,

    /* U+002E "." */
    0xf0,

    /* U+002F "/" */
    0x4, 0x21, 0x8, 0x42, 0x0,

    /* U+0030 "0" */
    0x74, 0x63, 0x18, 0xc5, 0xc0,

    /* U+0031 "1" */
    0x59, 0x24, 0xb8,

    /* U+0032 "2" */
    0x74, 0x42, 0x64, 0x43, 0xe0,

    /* U+0033 "3" */
    0x74, 0x42, 0x60, 0xc5, 0xc0,

    /* U+0034 "4" */
    0x19, 0x53, 0x1f, 0x84, 0x20,

    /* U+0035 "5" */
    0xfc, 0x21, 0xe0, 0xc5, 0xc0,

    /* U+0036 "6" */
    0x74, 0x61, 0xe8, 0xc5, 0xc0,

    /* U+0037 "7" */
    0xf8, 0x44, 0x22, 0x10, 0x80,

    /* U+0038 "8" */
    0x74, 0x62, 0xe8, 0xc5, 0xc0,

    /* U+0039 "9" */
    0x74, 0x62, 0xf0, 0xc5, 0xc0,

    /* U+003A ":" */
    0xf0, 0xf0,

    /* U+003B ";" */
    0xf0, 0xf8,

    /* U+003C "<" */
    0x12, 0x48, 0x42, 0x10,

    /* U+003D "=" */
    0xf0, 0xf0,

    /* U+003E ">" */
    0x84, 0x21, 0x24, 0x80,

    /* U+003F "?" */
    0x69, 0x12, 0x40, 0x40,

    /* U+0040 "@" */
    0x3c, 0x86, 0x6d, 0x59, 0xc8, 0xf, 0x0,

    /* U+0041 "A" */
    0x22, 0xa3, 0x1f, 0xc6, 0x20,

    /* U+0042 "B" */
    0xf4, 0x63, 0xe8, 0xc7, 0xc0,

    /* U+0043 "C" */
    0x74, 0x61, 0x8, 0x45, 0xc0,

    /* U+0044 "D" */
    0xf4, 0x63, 0x18, 0xc7, 0xc0,

    /* U+0045 "E" */
    0xf8, 0x8e, 0x88, 0xf0,

    /* U+0046 "F" */
    0xf8, 0x8e, 0x88, 0x80,

    /* U+0047 "G" */
    0x74, 0x61, 0x38, 0xc5, 0xc0,

    /* U+0048 "H" */
    0x8c, 0x63, 0xf8, 0xc6, 0x20,

    /* U+0049 "I" */
    0xfe,

    /* U+004A "J" */
    0x11, 0x11, 0x19, 0x60,

    /* U+004B "K" */
    0x8c, 0x65, 0xc9, 0x46, 0x20,

    /* U+004C "L" */
    0x88, 0x88, 0x88, 0xf0,

    /* U+004D "M" */
    0x83, 0x8e, 0xac, 0x98, 0x30, 0x60, 0x80,

    /* U+004E "N" */
    0x8e, 0x73, 0x59, 0xce, 0x20,

    /* U+004F "O" */
    0x74, 0x63, 0x18, 0xc5, 0xc0,

    /* U+0050 "P" */
    0xf4, 0x63, 0xe8, 0x42, 0x0,

    /* U+0051 "Q" */
    0x74, 0x63, 0x18, 0xc9, 0xa0,

    /* U+0052 "R" */
    0xf4, 0x63, 0xe8, 0xc6, 0x20,

    /* U+0053 "S" */
    0x74, 0x60, 0xe0, 0xc5, 0xc0,

    /* U+0054 "T" */
    0xf9, 0x8, 0x42, 0x10, 0x80,

    /* U+0055 "U" */
    0x8c, 0x63, 0x18, 0xc5, 0xc0,

    /* U+0056 "V" */
    0x8c, 0x63, 0x18, 0xa8, 0x80,

    /* U+0057 "W" */
    0x83, 0x6, 0xc, 0x9a, 0xb8, 0xe0, 0x80,

    /* U+0058 "X" */
    0x8c, 0x54, 0x45, 0x46, 0x20,

    /* U+0059 "Y" */
    0x8c, 0x54, 0x42, 0x10, 0x80,

    /* U+005A "Z" */
    0xf8, 0x44, 0x44, 0x43, 0xe0,

    /* U+005B "[" */
    0xf2, 0x49, 0x38,

    /* U+005C "\\" */
    0x81, 0x2, 0x4, 0x8, 0x10,

    /* U+005D "]" */
    0xe4, 0x92, 0x78,

    /* U+005E "^" */
    0x22, 0xa2,

    /* U+005F "_" */
    0xfe,

    /* U+0060 "`" */
    0xb4,

    /* U+0061 "a" */
    0x70, 0x5f, 0x17, 0x80,

    /* U+0062 "b" */
    0x84, 0x3d, 0x18, 0xc7, 0xc0,

    /* U+0063 "c" */
    0x74, 0x61, 0x17, 0x0,

    /* U+0064 "d" */
    0x8, 0x5f, 0x18, 0xc5, 0xe0,

    /* U+0065 "e" */
    0x74, 0x7f, 0x7, 0x80,

    /* U+0066 "f" */
    0x34, 0x4e, 0x44, 0x40,

    /* U+0067 "g" */
    0x7c, 0x63, 0x17, 0x87, 0xc0,

    /* U+0068 "h" */
    0x84, 0x3d, 0x18, 0xc6, 0x20,

    /* U+0069 "i" */
    0xbe,

    /* U+006A "j" */
    0x20, 0x92, 0x4e,

    /* U+006B "k" */
    0x88, 0x9a, 0xca, 0x90,

    /* U+006C "l" */
    0xfe,

    /* U+006D "m" */
    0xed, 0x26, 0x4c, 0x99, 0x20,

    /* U+006E "n" */
    0xf4, 0x63, 0x18, 0x80,

    /* U+006F "o" */
    0x74, 0x63, 0x17, 0x0,

    /* U+0070 "p" */
    0xf4, 0x63, 0x1f, 0x42, 0x0,

    /* U+0071 "q" */
    0x7c, 0x63, 0x17, 0x84, 0x20,

    /* U+0072 "r" */
    0xf4, 0x61, 0x8, 0x0,

    /* U+0073 "s" */
    0x7c, 0x1c, 0x1f, 0x0,

    /* U+0074 "t" */
    0x4b, 0xa4, 0x90,

    /* U+0075 "u" */
    0x8c, 0x63, 0x17, 0x80,

    /* U+0076 "v" */
    0x8c, 0x54, 0xa2, 0x0,

    /* U+0077 "w" */
    0x93, 0x26, 0x4c, 0x96, 0xc0,

    /* U+0078 "x" */
    0x8a, 0x88, 0xa8, 0x80,

    /* U+0079 "y" */
    0x8c, 0x62, 0x93, 0x85, 0xc0,

    /* U+007A "z" */
    0xf8, 0x88, 0x8f, 0x80,

    /* U+007B "{" */
    0x29, 0x44, 0x88,

    /* U+007C "|" */
    0xee,

    /* U+007D "}" */
    0x89, 0x14, 0xa0,

    /* U+007E "~" */
    0x61, 0x24, 0x30
};


/*---------------------
 *  GLYPH DESCRIPTION
 *--------------------*/

static const lv_font_fmt_txt_glyph_dsc_t glyph_dsc[] = {
    {.bitmap_index = 0, .adv_w = 0, .box_w = 0, .box_h = 0, .ofs_x = 0, .ofs_y = 0} /* id = 0 reserved */,
    {.bitmap_index = 0, .adv_w = 60, .box_w = 1, .box_h = 1, .ofs_x = 0, .ofs_y = 0},
    {.bitmap_index = 1, .adv_w = 30, .box_w = 1, .box_h = 7, .ofs_x = 0, .ofs_y = 0},
    {.bitmap_index = 2, .adv_w = 60, .box_w = 3, .box_h = 2, .ofs_x = 0, .ofs_y = 5},
    {.bitmap_index = 3, .adv_w = 120, .box_w = 7, .box_h = 7, .ofs_x = 0, .ofs_y = 0},
    {.bitmap_index = 10, .adv_w = 90, .box_w = 5, .box_h = 7, .ofs_x = 0, .ofs_y = 0},
    {.bitmap_index = 15, .adv_w = 120, .box_w = 7, .box_h = 7, .ofs_x = 0, .ofs_y = 0},
    {.bitmap_index = 22, .adv_w = 75, .box_w = 4, .box_h = 7, .ofs_x = 0, .ofs_y = 0},
    {.bitmap_index = 26, .adv_w = 45, .box_w = 2, .box_h = 3, .ofs_x = 0, .ofs_y = 4},
    {.bitmap_index = 27, .adv_w = 60, .box_w = 3, .box_h = 7, .ofs_x = 0, .ofs_y = 0},
    {.bitmap_index = 30, .adv_w = 60, .box_w = 3, .box_h = 7, .ofs_x = 0, .ofs_y = 0},
    {.bitmap_index = 33, .adv_w = 105, .box_w = 6, .box_h = 5, .ofs_x = 0, .ofs_y = 2},
    {.bitmap_index = 37, .adv_w = 90, .box_w = 5, .box_h = 5, .ofs_x = 0, .ofs_y = 2},
    {.bitmap_index = 41, .adv_w = 45, .box_w = 2, .box_h = 3, .ofs_x = 0, .ofs_y = -1},
    {.bitmap_index = 42, .adv_w = 60, .box_w = 3, .box_h = 1, .ofs_x = 0, .ofs_y = 3},
    {.bitmap_index = 43, .adv_w = 45, .box_w = 2, .box_h = 2, .ofs_x = 0, .ofs_y = 0},
    {.bitmap_index = 44, .adv_w = 105, .box_w = 6, .box_h = 6, .ofs_x = 0, .ofs_y = 0},
    {.bitmap_index = 49, .adv_w = 90, .box_w = 5, .box_h = 7, .ofs_x = 0, .ofs_y = 0},
    {.bitmap_index = 54, .adv_w = 60, .box_w = 3, .box_h = 7, .ofs_x = 0, .ofs_y = 0},
    {.bitmap_index = 57, .adv_w = 90, .box_w = 5, .box_h = 7, .ofs_x = 0, .ofs_y = 0},
    {.bitmap_index = 62, .adv_w = 90, .box_w = 5, .box_h = 7, .ofs_x = 0, .ofs_y = 0},
    {.bitmap_index = 67, .adv_w = 90, .box_w = 5, .box_h = 7, .ofs_x = 0, .ofs_y = 0},
    {.bitmap_index = 72, .adv_w = 90, .box_w = 5, .box_h = 7, .ofs_x = 0, .ofs_y = 0},
    {.bitmap_index = 77, .adv_w = 90, .box_w = 5, .box_h = 7, .ofs_x = 0, .ofs_y = 0},
    {.bitmap_index = 82, .adv_w = 90, .box_w = 5, .box_h = 7, .ofs_x = 0, .ofs_y = 0},
    {.bitmap_index = 87, .adv_w = 90, .box_w = 5, .box_h = 7, .ofs_x = 0, .ofs_y = 0},
    {.bitmap_index = 92, .adv_w = 90, .box_w = 5, .box_h = 7, .ofs_x = 0, .ofs_y = 0},
    {.bitmap_index = 97, .adv_w = 45, .box_w = 2, .box_h = 6, .ofs_x = 0, .ofs_y = 0},
    {.bitmap_index = 99, .adv_w = 45, .box_w = 2, .box_h = 7, .ofs_x = 0, .ofs_y = -1},
    {.bitmap_index = 101, .adv_w = 75, .box_w = 4, .box_h = 7, .ofs_x = 0, .ofs_y = 0},
    {.bitmap_index = 105, .adv_w = 75, .box_w = 4, .box_h = 3, .ofs_x = 0, .ofs_y = 2},
    {.bitmap_index = 107, .adv_w = 75, .box_w = 4, .box_h = 7, .ofs_x = 0, .ofs_y = 0},
    {.bitmap_index = 111, .adv_w = 75, .box_w = 4, .box_h = 7, .ofs_x = 0, .ofs_y = 0},
    {.bitmap_index = 115, .adv_w = 119, .box_w = 7, .box_h = 7, .ofs_x = 0, .ofs_y = 0},
    {.bitmap_index = 122, .adv_w = 90, .box_w = 5, .box_h = 7, .ofs_x = 0, .ofs_y = 0},
    {.bitmap_index = 127, .adv_w = 90, .box_w = 5, .box_h = 7, .ofs_x = 0, .ofs_y = 0},
    {.bitmap_index = 132, .adv_w = 90, .box_w = 5, .box_h = 7, .ofs_x = 0, .ofs_y = 0},
    {.bitmap_index = 137, .adv_w = 90, .box_w = 5, .box_h = 7, .ofs_x = 0, .ofs_y = 0},
    {.bitmap_index = 142, .adv_w = 75, .box_w = 4, .box_h = 7, .ofs_x = 0, .ofs_y = 0},
    {.bitmap_index = 146, .adv_w = 75, .box_w = 4, .box_h = 7, .ofs_x = 0, .ofs_y = 0},
    {.bitmap_index = 150, .adv_w = 90, .box_w = 5, .box_h = 7, .ofs_x = 0, .ofs_y = 0},
    {.bitmap_index = 155, .adv_w = 90, .box_w = 5, .box_h = 7, .ofs_x = 0, .ofs_y = 0},
    {.bitmap_index = 160, .adv_w = 30, .box_w = 1, .box_h = 7, .ofs_x = 0, .ofs_y = 0},
    {.bitmap_index = 161, .adv_w = 75, .box_w = 4, .box_h = 7, .ofs_x = 0, .ofs_y = 0},
    {.bitmap_index = 165, .adv_w = 90, .box_w = 5, .box_h = 7, .ofs_x = 0, .ofs_y = 0},
    {.bitmap_index = 170, .adv_w = 75, .box_w = 4, .box_h = 7, .ofs_x = 0, .ofs_y = 0},
    {.bitmap_index = 174, .adv_w = 119, .box_w = 7, .box_h = 7, .ofs_x = 0, .ofs_y = 0},
    {.bitmap_index = 181, .adv_w = 90, .box_w = 5, .box_h = 7, .ofs_x = 0, .ofs_y = 0},
    {.bitmap_index = 186, .adv_w = 90, .box_w = 5, .box_h = 7, .ofs_x = 0, .ofs_y = 0},
    {.bitmap_index = 191, .adv_w = 90, .box_w = 5, .box_h = 7, .ofs_x = 0, .ofs_y = 0},
    {.bitmap_index = 196, .adv_w = 90, .box_w = 5, .box_h = 7, .ofs_x = 0, .ofs_y = 0},
    {.bitmap_index = 201, .adv_w = 90, .box_w = 5, .box_h = 7, .ofs_x = 0, .ofs_y = 0},
    {.bitmap_index = 206, .adv_w = 90, .box_w = 5, .box_h = 7, .ofs_x = 0, .ofs_y = 0},
    {.bitmap_index = 211, .adv_w = 90, .box_w = 5, .box_h = 7, .ofs_x = 0, .ofs_y = 0},
    {.bitmap_index = 216, .adv_w = 90, .box_w = 5, .box_h = 7, .ofs_x = 0, .ofs_y = 0},
    {.bitmap_index = 221, .adv_w = 90, .box_w = 5, .box_h = 7, .ofs_x = 0, .ofs_y = 0},
    {.bitmap_index = 226, .adv_w = 120, .box_w = 7, .box_h = 7, .ofs_x = 0, .ofs_y = 0},
    {.bitmap_index = 233, .adv_w = 90, .box_w = 5, .box_h = 7, .ofs_x = 0, .ofs_y = 0},
    {.bitmap_index = 238, .adv_w = 90, .box_w = 5, .box_h = 7, .ofs_x = 0, .ofs_y = 0},
    {.bitmap_index = 243, .adv_w = 90, .box_w = 5, .box_h = 7, .ofs_x = 0, .ofs_y = 0},
    {.bitmap_index = 248, .adv_w = 60, .box_w = 3, .box_h = 7, .ofs_x = 0, .ofs_y = 0},
    {.bitmap_index = 251, .adv_w = 105, .box_w = 6, .box_h = 6, .ofs_x = 0, .ofs_y = 0},
    {.bitmap_index = 256, .adv_w = 60, .box_w = 3, .box_h = 7, .ofs_x = 0, .ofs_y = 0},
    {.bitmap_index = 259, .adv_w = 90, .box_w = 5, .box_h = 3, .ofs_x = 0, .ofs_y = 4},
    {.bitmap_index = 261, .adv_w = 120, .box_w = 7, .box_h = 1, .ofs_x = 0, .ofs_y = 0},
    {.bitmap_index = 262, .adv_w = 45, .box_w = 2, .box_h = 3, .ofs_x = 0, .ofs_y = 4},
    {.bitmap_index = 263, .adv_w = 90, .box_w = 5, .box_h = 5, .ofs_x = 0, .ofs_y = 0},
    {.bitmap_index = 267, .adv_w = 90, .box_w = 5, .box_h = 7, .ofs_x = 0, .ofs_y = 0},
    {.bitmap_index = 272, .adv_w = 90, .box_w = 5, .box_h = 5, .ofs_x = 0, .ofs_y = 0},
    {.bitmap_index = 276, .adv_w = 90, .box_w = 5, .box_h = 7, .ofs_x = 0, .ofs_y = 0},
    {.bitmap_index = 281, .adv_w = 90, .box_w = 5, .box_h = 5, .ofs_x = 0, .ofs_y = 0},
    {.bitmap_index = 285, .adv_w = 75, .box_w = 4, .box_h = 7, .ofs_x = 0, .ofs_y = 0},
    {.bitmap_index = 289, .adv_w = 90, .box_w = 5, .box_h = 7, .ofs_x = 0, .ofs_y = -2},
    {.bitmap_index = 294, .adv_w = 90, .box_w = 5, .box_h = 7, .ofs_x = 0, .ofs_y = 0},
    {.bitmap_index = 299, .adv_w = 30, .box_w = 1, .box_h = 7, .ofs_x = 0, .ofs_y = 0},
    {.bitmap_index = 300, .adv_w = 60, .box_w = 3, .box_h = 8, .ofs_x = 0, .ofs_y = -1},
    {.bitmap_index = 303, .adv_w = 75, .box_w = 4, .box_h = 7, .ofs_x = 0, .ofs_y = 0},
    {.bitmap_index = 307, .adv_w = 30, .box_w = 1, .box_h = 7, .ofs_x = 0, .ofs_y = 0},
    {.bitmap_index = 308, .adv_w = 120, .box_w = 7, .box_h = 5, .ofs_x = 0, .ofs_y = 0},
    {.bitmap_index = 313, .adv_w = 90, .box_w = 5, .box_h = 5, .ofs_x = 0, .ofs_y = 0},
    {.bitmap_index = 317, .adv_w = 90, .box_w = 5, .box_h = 5, .ofs_x = 0, .ofs_y = 0},
    {.bitmap_index = 321, .adv_w = 90, .box_w = 5, .box_h = 7, .ofs_x = 0, .ofs_y = -2},
    {.bitmap_index = 326, .adv_w = 90, .box_w = 5, .box_h = 7, .ofs_x = 0, .ofs_y = -2},
    {.bitmap_index = 331, .adv_w = 90, .box_w = 5, .box_h = 5, .ofs_x = 0, .ofs_y = 0},
    {.bitmap_index = 335, .adv_w = 90, .box_w = 5, .box_h = 5, .ofs_x = 0, .ofs_y = 0},
    {.bitmap_index = 339, .adv_w = 60, .box_w = 3, .box_h = 7, .ofs_x = 0, .ofs_y = 0},
    {.bitmap_index = 342, .adv_w = 90, .box_w = 5, .box_h = 5, .ofs_x = 0, .ofs_y = 0},
    {.bitmap_index = 346, .adv_w = 90, .box_w = 5, .box_h = 5, .ofs_x = 0, .ofs_y = 0},
    {.bitmap_index = 350, .adv_w = 119, .box_w = 7, .box_h = 5, .ofs_x = 0, .ofs_y = 0},
    {.bitmap_index = 355, .adv_w = 90, .box_w = 5, .box_h = 5, .ofs_x = 0, .ofs_y = 0},
    {.bitmap_index = 359, .adv_w = 90, .box_w = 5, .box_h = 7, .ofs_x = 0, .ofs_y = -2},
    {.bitmap_index = 364, .adv_w = 90, .box_w = 5, .box_h = 5, .ofs_x = 0, .ofs_y = 0},
    {.bitmap_index = 368, .adv_w = 60, .box_w = 3, .box_h = 7, .ofs_x = 0, .ofs_y = 0},
    {.bitmap_index = 371, .adv_w = 30, .box_w = 1, .box_h = 7, .ofs_x = 0, .ofs_y = 0},
    {.bitmap_index = 372, .adv_w = 60, .box_w = 3, .box_h = 7, .ofs_x = 0, .ofs_y = 0},
    {.bitmap_index = 375, .adv_w = 120, .box_w = 7, .box_h = 3, .ofs_x = 0, .ofs_y = 2}
};

/*---------------------
 *  CHARACTER MAPPING
 *--------------------*/



/*Collect the unicode lists and glyph_id offsets*/
static const lv_font_fmt_txt_cmap_t cmaps[] =
{
    {
        .range_start = 32, .range_length = 95, .glyph_id_start = 1,
        .unicode_list = NULL, .glyph_id_ofs_list = NULL, .list_length = 0, .type = LV_FONT_FMT_TXT_CMAP_FORMAT0_TINY
    }
};



/*--------------------
 *  ALL CUSTOM DATA
 *--------------------*/

#if LVGL_VERSION_MAJOR == 8
/*Store all the custom data of the font*/
static  lv_font_fmt_txt_glyph_cache_t cache;
#endif

#if LVGL_VERSION_MAJOR >= 8
static const lv_font_fmt_txt_dsc_t font_dsc = {
#else
static lv_font_fmt_txt_dsc_t font_dsc = {
#endif
    .glyph_bitmap = glyph_bitmap,
    .glyph_dsc = glyph_dsc,
    .cmaps = cmaps,
    .kern_dsc = NULL,
    .kern_scale = 0,
    .cmap_num = 1,
    .bpp = 1,
    .kern_classes = 0,
    .bitmap_format = 0,
#if LVGL_VERSION_MAJOR == 8
    .cache = &cache
#endif

};



/*-----------------
 *  PUBLIC FONT
 *----------------*/

/*Initialize a public general font descriptor*/
#if LVGL_VERSION_MAJOR >= 8
const lv_font_t cnc = {
#else
lv_font_t cnc = {
#endif
    .get_glyph_dsc = lv_font_get_glyph_dsc_fmt_txt,    /*Function pointer to get glyph's data*/
    .get_glyph_bitmap = lv_font_get_bitmap_fmt_txt,    /*Function pointer to get glyph's bitmap*/
    .line_height = 9,          /*The maximum line height required by the font*/
    .base_line = 2,             /*Baseline measured from the bottom of the line*/
#if !(LVGL_VERSION_MAJOR == 6 && LVGL_VERSION_MINOR == 0)
    .subpx = LV_FONT_SUBPX_NONE,
#endif
#if LV_VERSION_CHECK(7, 4, 0) || LVGL_VERSION_MAJOR >= 8
    .underline_position = -1,
    .underline_thickness = 1,
#endif
    .dsc = &font_dsc,          /*The custom font data. Will be accessed by `get_glyph_bitmap/dsc` */
#if LV_VERSION_CHECK(8, 2, 0) || LVGL_VERSION_MAJOR >= 9
    .fallback = NULL,
#endif
    .user_data = NULL,
};



#endif /*#if CNC*/
