smartuni/riot-po-2026/nodes/firmware/applications/senseMate/sensemate_ui/helvetica10.c

/*******************************************************************************
 * Size: 10 px
 * Bpp: 1
 * Opts: --bpp 1 --size 10 --no-compress --stride 1 --align 1 --font Helvetica.ttf --range 32-127 --format lvgl -o helvetica10.c
 ******************************************************************************/

#ifdef __has_include
    #if __has_include("lvgl.h")
        #ifndef LV_LVGL_H_INCLUDE_SIMPLE
            #define LV_LVGL_H_INCLUDE_SIMPLE
        #endif
    #endif
#endif

#ifdef LV_LVGL_H_INCLUDE_SIMPLE
    #include "lvgl.h"
#else
    #include "lvgl/lvgl.h"
#endif



#ifndef HELVETICA10
#define HELVETICA10 1
#endif

#if HELVETICA10

/*-----------------
 *    BITMAPS
 *----------------*/

/*Store the image of the glyphs*/
static LV_ATTRIBUTE_LARGE_CONST const uint8_t glyph_bitmap[] = {
    /* U+0020 " " */
    0x0,

    /* U+0021 "!" */
    0xfd,

    /* U+0022 "\"" */
    0xb6, 0x80,

    /* U+0023 "#" */
    0x28, 0xa7, 0x94, 0x53, 0xe5, 0x28,

    /* U+0024 "$" */
    0x23, 0xab, 0x4e, 0x38, 0xb5, 0xf1, 0x0,

    /* U+0025 "%" */
    0x60, 0x94, 0x98, 0x68, 0x12, 0x15, 0x25, 0x22,

    /* U+0026 "&" */
    0x31, 0x45, 0x8, 0xea, 0x6d, 0x9b,

    /* U+0027 "'" */
    0xe0,

    /* U+0028 "(" */
    0x5a, 0xaa, 0x50,

    /* U+0029 ")" */
    0xa5, 0x55, 0xa0,

    /* U+002A "*" */
    0x5e, 0x80,

    /* U+002B "+" */
    0x21, 0x9, 0xf2, 0x10,

    /* U+002C "," */
    0xc0,

    /* U+002D "-" */
    0xc0,

    /* U+002E "." */
    0x80,

    /* U+002F "/" */
    0x25, 0x25, 0x24,

    /* U+0030 "0" */
    0x76, 0x63, 0x18, 0xc7, 0x6e,

    /* U+0031 "1" */
    0x3c, 0x92, 0x49,

    /* U+0032 "2" */
    0x72, 0x62, 0x13, 0x22, 0xf,

    /* U+0033 "3" */
    0x72, 0x42, 0x60, 0xc5, 0x2e,

    /* U+0034 "4" */
    0x11, 0x94, 0xa9, 0x7c, 0x42,

    /* U+0035 "5" */
    0x7a, 0x20, 0xe8, 0x86, 0x2e,

    /* U+0036 "6" */
    0x76, 0x61, 0xe8, 0xc6, 0x2e,

    /* U+0037 "7" */
    0xf8, 0x44, 0x42, 0x11, 0x8,

    /* U+0038 "8" */
    0x74, 0x62, 0xe8, 0xc6, 0x2e,

    /* U+0039 "9" */
    0x74, 0x63, 0x17, 0x86, 0x4e,

    /* U+003A ":" */
    0x84,

    /* U+003B ";" */
    0x86,

    /* U+003C "<" */
    0x4, 0x6e, 0x30, 0x30, 0x30,

    /* U+003D "=" */
    0xfc, 0xf, 0xc0,

    /* U+003E ">" */
    0x81, 0x81, 0x83, 0x72, 0x0,

    /* U+003F "?" */
    0x72, 0x62, 0x23, 0x10, 0x4,

    /* U+0040 "@" */
    0x3e, 0x5f, 0xb5, 0xa9, 0xa9, 0xb6, 0x42, 0x3c,

    /* U+0041 "A" */
    0x10, 0x60, 0xa1, 0x44, 0x8f, 0x91, 0x42,

    /* U+0042 "B" */
    0xf2, 0x28, 0xbc, 0x8e, 0x18, 0x7e,

    /* U+0043 "C" */
    0x39, 0x18, 0x60, 0x82, 0x14, 0x5e,

    /* U+0044 "D" */
    0xfa, 0x28, 0x61, 0x86, 0x18, 0xbe,

    /* U+0045 "E" */
    0xfc, 0x21, 0xf8, 0x42, 0x1f,

    /* U+0046 "F" */
    0xfc, 0x21, 0xf8, 0x42, 0x10,

    /* U+0047 "G" */
    0x3c, 0x8e, 0x4, 0x78, 0x30, 0x51, 0x9d,

    /* U+0048 "H" */
    0x86, 0x18, 0x7f, 0x86, 0x18, 0x61,

    /* U+0049 "I" */
    0xff,

    /* U+004A "J" */
    0x11, 0x11, 0x19, 0x96,

    /* U+004B "K" */
    0x8a, 0x4b, 0x38, 0xf2, 0x48, 0xa3,

    /* U+004C "L" */
    0x84, 0x21, 0x8, 0x42, 0x1f,

    /* U+004D "M" */
    0xc7, 0x8f, 0x1d, 0x5a, 0xb5, 0x6c, 0xc9,

    /* U+004E "N" */
    0xc7, 0x1a, 0x69, 0x96, 0x58, 0xe1,

    /* U+004F "O" */
    0x38, 0x8a, 0xc, 0x18, 0x30, 0x51, 0x1c,

    /* U+0050 "P" */
    0xf4, 0x63, 0x1f, 0x42, 0x10,

    /* U+0051 "Q" */
    0x38, 0x8a, 0xc, 0x18, 0x30, 0x53, 0x1f,

    /* U+0052 "R" */
    0xfa, 0x18, 0x61, 0xfa, 0x18, 0x61,

    /* U+0053 "S" */
    0x7a, 0x38, 0x38, 0x1e, 0x18, 0x5e,

    /* U+0054 "T" */
    0xf9, 0x8, 0x42, 0x10, 0x84,

    /* U+0055 "U" */
    0x86, 0x18, 0x61, 0x86, 0x1c, 0xde,

    /* U+0056 "V" */
    0x84, 0x89, 0x12, 0x42, 0x85, 0xc, 0x8,

    /* U+0057 "W" */
    0x88, 0xa6, 0x55, 0x2a, 0xa5, 0x52, 0x98, 0x8c,
    0x46,

    /* U+0058 "X" */
    0x44, 0x90, 0xa0, 0x83, 0x5, 0x13, 0x22,

    /* U+0059 "Y" */
    0x44, 0x88, 0xa1, 0x41, 0x2, 0x4, 0x8,

    /* U+005A "Z" */
    0xfc, 0x21, 0xc, 0x21, 0xc, 0x3f,

    /* U+005B "[" */
    0xea, 0xaa, 0xb0,

    /* U+005C "\\" */
    0x92, 0x24, 0x89,

    /* U+005D "]" */
    0xd5, 0x55, 0x70,

    /* U+005E "^" */
    0x44, 0xaa, 0x90,

    /* U+005F "_" */
    0xfc,

    /* U+0060 "`" */
    0x90,

    /* U+0061 "a" */
    0x74, 0x85, 0xe9, 0x7c,

    /* U+0062 "b" */
    0x84, 0x3d, 0x18, 0xc6, 0x3e,

    /* U+0063 "c" */
    0x74, 0xa1, 0x9, 0x38,

    /* U+0064 "d" */
    0x8, 0x5f, 0x18, 0xc6, 0x2f,

    /* U+0065 "e" */
    0x74, 0x7f, 0x8, 0xb8,

    /* U+0066 "f" */
    0x6b, 0xa4, 0x92,

    /* U+0067 "g" */
    0x7c, 0x63, 0x18, 0xbe, 0x2e,

    /* U+0068 "h" */
    0x88, 0xf9, 0x99, 0x99,

    /* U+0069 "i" */
    0xbf,

    /* U+006A "j" */
    0x45, 0x55, 0x70,

    /* U+006B "k" */
    0x84, 0x25, 0x4e, 0x52, 0x52,

    /* U+006C "l" */
    0xff,

    /* U+006D "m" */
    0xff, 0x26, 0x4c, 0x99, 0x32, 0x40,

    /* U+006E "n" */
    0xf9, 0x99, 0x99,

    /* U+006F "o" */
    0x74, 0x63, 0x18, 0xb8,

    /* U+0070 "p" */
    0xf4, 0x63, 0x18, 0xfa, 0x10,

    /* U+0071 "q" */
    0x7c, 0x63, 0x18, 0xbc, 0x21,

    /* U+0072 "r" */
    0xf2, 0x49, 0x0,

    /* U+0073 "s" */
    0xe9, 0xc3, 0x9e,

    /* U+0074 "t" */
    0x4b, 0xa4, 0x93,

    /* U+0075 "u" */
    0x99, 0x99, 0x9f,

    /* U+0076 "v" */
    0x8a, 0x94, 0xa6, 0x10,

    /* U+0077 "w" */
    0x93, 0x25, 0xb3, 0x66, 0xcd, 0x80,

    /* U+0078 "x" */
    0xd2, 0x88, 0x45, 0x4c,

    /* U+0079 "y" */
    0x8a, 0x94, 0xa2, 0x10, 0x88,

    /* U+007A "z" */
    0xf8, 0x88, 0x8c, 0x7c,

    /* U+007B "{" */
    0x29, 0x2d, 0x12, 0x4c,

    /* U+007C "|" */
    0xff,

    /* U+007D "}" */
    0x89, 0x26, 0x52, 0x58,

    /* U+007E "~" */
    0x66, 0x60
};


/*---------------------
 *  GLYPH DESCRIPTION
 *--------------------*/

static const lv_font_fmt_txt_glyph_dsc_t glyph_dsc[] = {
    {.bitmap_index = 0, .adv_w = 0, .box_w = 0, .box_h = 0, .ofs_x = 0, .ofs_y = 0} /* id = 0 reserved */,
    {.bitmap_index = 0, .adv_w = 44, .box_w = 1, .box_h = 1, .ofs_x = 0, .ofs_y = 0},
    {.bitmap_index = 1, .adv_w = 44, .box_w = 1, .box_h = 8, .ofs_x = 1, .ofs_y = 0},
    {.bitmap_index = 2, .adv_w = 57, .box_w = 3, .box_h = 3, .ofs_x = 1, .ofs_y = 5},
    {.bitmap_index = 4, .adv_w = 89, .box_w = 6, .box_h = 8, .ofs_x = 0, .ofs_y = 0},
    {.bitmap_index = 10, .adv_w = 89, .box_w = 5, .box_h = 10, .ofs_x = 1, .ofs_y = -1},
    {.bitmap_index = 17, .adv_w = 142, .box_w = 8, .box_h = 8, .ofs_x = 1, .ofs_y = 0},
    {.bitmap_index = 25, .adv_w = 107, .box_w = 6, .box_h = 8, .ofs_x = 1, .ofs_y = 0},
    {.bitmap_index = 31, .adv_w = 31, .box_w = 1, .box_h = 3, .ofs_x = 1, .ofs_y = 5},
    {.bitmap_index = 32, .adv_w = 53, .box_w = 2, .box_h = 10, .ofs_x = 1, .ofs_y = -2},
    {.bitmap_index = 35, .adv_w = 53, .box_w = 2, .box_h = 10, .ofs_x = 1, .ofs_y = -2},
    {.bitmap_index = 38, .adv_w = 62, .box_w = 3, .box_h = 3, .ofs_x = 1, .ofs_y = 5},
    {.bitmap_index = 40, .adv_w = 93, .box_w = 5, .box_h = 6, .ofs_x = 1, .ofs_y = 0},
    {.bitmap_index = 44, .adv_w = 44, .box_w = 1, .box_h = 3, .ofs_x = 1, .ofs_y = -2},
    {.bitmap_index = 45, .adv_w = 53, .box_w = 2, .box_h = 1, .ofs_x = 1, .ofs_y = 3},
    {.bitmap_index = 46, .adv_w = 44, .box_w = 1, .box_h = 1, .ofs_x = 1, .ofs_y = 0},
    {.bitmap_index = 47, .adv_w = 44, .box_w = 3, .box_h = 8, .ofs_x = 0, .ofs_y = 0},
    {.bitmap_index = 50, .adv_w = 89, .box_w = 5, .box_h = 8, .ofs_x = 1, .ofs_y = 0},
    {.bitmap_index = 55, .adv_w = 89, .box_w = 3, .box_h = 8, .ofs_x = 1, .ofs_y = 0},
    {.bitmap_index = 58, .adv_w = 89, .box_w = 5, .box_h = 8, .ofs_x = 0, .ofs_y = 0},
    {.bitmap_index = 63, .adv_w = 89, .box_w = 5, .box_h = 8, .ofs_x = 0, .ofs_y = 0},
    {.bitmap_index = 68, .adv_w = 89, .box_w = 5, .box_h = 8, .ofs_x = 1, .ofs_y = 0},
    {.bitmap_index = 73, .adv_w = 89, .box_w = 5, .box_h = 8, .ofs_x = 0, .ofs_y = 0},
    {.bitmap_index = 78, .adv_w = 89, .box_w = 5, .box_h = 8, .ofs_x = 1, .ofs_y = 0},
    {.bitmap_index = 83, .adv_w = 89, .box_w = 5, .box_h = 8, .ofs_x = 0, .ofs_y = 0},
    {.bitmap_index = 88, .adv_w = 89, .box_w = 5, .box_h = 8, .ofs_x = 1, .ofs_y = 0},
    {.bitmap_index = 93, .adv_w = 89, .box_w = 5, .box_h = 8, .ofs_x = 1, .ofs_y = 0},
    {.bitmap_index = 98, .adv_w = 44, .box_w = 1, .box_h = 6, .ofs_x = 1, .ofs_y = 0},
    {.bitmap_index = 99, .adv_w = 44, .box_w = 1, .box_h = 8, .ofs_x = 1, .ofs_y = -2},
    {.bitmap_index = 100, .adv_w = 93, .box_w = 6, .box_h = 6, .ofs_x = 1, .ofs_y = 0},
    {.bitmap_index = 105, .adv_w = 93, .box_w = 6, .box_h = 3, .ofs_x = 0, .ofs_y = 1},
    {.bitmap_index = 108, .adv_w = 93, .box_w = 6, .box_h = 6, .ofs_x = 1, .ofs_y = 0},
    {.bitmap_index = 113, .adv_w = 89, .box_w = 5, .box_h = 8, .ofs_x = 0, .ofs_y = 0},
    {.bitmap_index = 118, .adv_w = 162, .box_w = 8, .box_h = 8, .ofs_x = 1, .ofs_y = 0},
    {.bitmap_index = 126, .adv_w = 107, .box_w = 7, .box_h = 8, .ofs_x = 0, .ofs_y = 0},
    {.bitmap_index = 133, .adv_w = 107, .box_w = 6, .box_h = 8, .ofs_x = 1, .ofs_y = 0},
    {.bitmap_index = 139, .adv_w = 116, .box_w = 6, .box_h = 8, .ofs_x = 1, .ofs_y = 0},
    {.bitmap_index = 145, .adv_w = 116, .box_w = 6, .box_h = 8, .ofs_x = 1, .ofs_y = 0},
    {.bitmap_index = 151, .adv_w = 107, .box_w = 5, .box_h = 8, .ofs_x = 1, .ofs_y = 0},
    {.bitmap_index = 156, .adv_w = 98, .box_w = 5, .box_h = 8, .ofs_x = 1, .ofs_y = 0},
    {.bitmap_index = 161, .adv_w = 124, .box_w = 7, .box_h = 8, .ofs_x = 1, .ofs_y = 0},
    {.bitmap_index = 168, .adv_w = 116, .box_w = 6, .box_h = 8, .ofs_x = 1, .ofs_y = 0},
    {.bitmap_index = 174, .adv_w = 44, .box_w = 1, .box_h = 8, .ofs_x = 1, .ofs_y = 0},
    {.bitmap_index = 175, .adv_w = 80, .box_w = 4, .box_h = 8, .ofs_x = 1, .ofs_y = 0},
    {.bitmap_index = 179, .adv_w = 107, .box_w = 6, .box_h = 8, .ofs_x = 1, .ofs_y = 0},
    {.bitmap_index = 185, .adv_w = 89, .box_w = 5, .box_h = 8, .ofs_x = 1, .ofs_y = 0},
    {.bitmap_index = 190, .adv_w = 133, .box_w = 7, .box_h = 8, .ofs_x = 1, .ofs_y = 0},
    {.bitmap_index = 197, .adv_w = 116, .box_w = 6, .box_h = 8, .ofs_x = 1, .ofs_y = 0},
    {.bitmap_index = 203, .adv_w = 124, .box_w = 7, .box_h = 8, .ofs_x = 1, .ofs_y = 0},
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
    {.bitmap_index = 402, .adv_w = 53, .box_w = 3, .box_h = 10, .ofs_x = 0, .ofs_y = -2},
    {.bitmap_index = 406, .adv_w = 93, .box_w = 6, .box_h = 2, .ofs_x = 0, .ofs_y = 2}
};

/*---------------------
 *  CHARACTER MAPPING
 *--------------------*/



/*Collect the unicode lists and glyph_id offsets*/
static const lv_font_fmt_txt_cmap_t cmaps[] =
{
    {
        .range_start = 32, .range_length = 95, .glyph_id_start = 1,
        .unicode_list = NULL, .glyph_id_ofs_list = NULL, .list_length = 0, .type = LV_FONT_FMT_TXT_CMAP_FORMAT0_TINY
    }
};

/*-----------------
 *    KERNING
 *----------------*/


/*Pair left and right glyphs for kerning*/
static const uint8_t kern_pair_glyph_ids[] =
{
    1, 34,
    1, 53,
    1, 58,
    18, 18,
    34, 1,
    34, 53,
    34, 55,
    34, 56,
    34, 58,
    34, 87,
    34, 88,
    34, 90,
    39, 13,
    39, 15,
    39, 34,
    45, 1,
    45, 53,
    45, 55,
    45, 56,
    45, 58,
    45, 90,
    49, 1,
    49, 13,
    49, 15,
    49, 34,
    51, 53,
    51, 55,
    51, 56,
    51, 58,
    53, 1,
    53, 13,
    53, 14,
    53, 15,
    53, 27,
    53, 28,
    53, 34,
    53, 48,
    53, 66,
    53, 68,
    53, 70,
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
};

/* Kerning between the respective left and right glyphs
 * 4.4 format which needs to scaled with `kern_scale`*/
static const int8_t kern_pair_values[] =
{
    -9, -3, -3, -12, -9, -12, -12, -6,
    -12, -3, -3, -3, -18, -18, -9, -6,
    -12, -12, -12, -12, -6, -3, -21, -21,
    -12, -3, -3, -3, -3, -3, -18, -9,
    -18, -18, -18, -12, -3, -18, -18, -18,
    -6, -18, -6, -18, -6, -9, -9, -15,
    -9, -15, -6, -6, -12, -12, -9, -3,
    -9, -6, -6, -6, -9, -3, -9, -3,
    -3, -6, -6, -3, -3, -3, -3, -1,
    -3, -21, -15, -21, -9, -10, -12, -12,
    -15, -6, -15, -12, -15, -9, -9, -3,
    -9, -9, -12, -12, -9, -9, -12, -12
};

/*Collect the kern pair's data in one place*/
static const lv_font_fmt_txt_kern_pair_t kern_pairs =
{
    .glyph_ids = kern_pair_glyph_ids,
    .values = kern_pair_values,
    .pair_cnt = 96,
    .glyph_ids_size = 0
};

/*--------------------
 *  ALL CUSTOM DATA
 *--------------------*/

#if LVGL_VERSION_MAJOR == 8
/*Store all the custom data of the font*/
static  lv_font_fmt_txt_glyph_cache_t cache;
#endif

#if LVGL_VERSION_MAJOR >= 8
static const lv_font_fmt_txt_dsc_t font_dsc = {
#else
static lv_font_fmt_txt_dsc_t font_dsc = {
#endif
    .glyph_bitmap = glyph_bitmap,
    .glyph_dsc = glyph_dsc,
    .cmaps = cmaps,
    .kern_dsc = &kern_pairs,
    .kern_scale = 16,
    .cmap_num = 1,
    .bpp = 1,
    .kern_classes = 0,
    .bitmap_format = 0,
#if LVGL_VERSION_MAJOR == 8
    .cache = &cache
#endif

};



/*-----------------
 *  PUBLIC FONT
 *----------------*/

/*Initialize a public general font descriptor*/
#if LVGL_VERSION_MAJOR >= 8
const lv_font_t helvetica10 = {
#else
lv_font_t helvetica10 = {
#endif
    .get_glyph_dsc = lv_font_get_glyph_dsc_fmt_txt,    /*Function pointer to get glyph's data*/
    .get_glyph_bitmap = lv_font_get_bitmap_fmt_txt,    /*Function pointer to get glyph's bitmap*/
    .line_height = 11,          /*The maximum line height required by the font*/
    .base_line = 2,             /*Baseline measured from the bottom of the line*/
#if !(LVGL_VERSION_MAJOR == 6 && LVGL_VERSION_MINOR == 0)
    .subpx = LV_FONT_SUBPX_NONE,
#endif
#if LV_VERSION_CHECK(7, 4, 0) || LVGL_VERSION_MAJOR >= 8
    .underline_position = -1,
    .underline_thickness = 0,
#endif
    //.static_bitmap = 0,
    .dsc = &font_dsc,          /*The custom font data. Will be accessed by `get_glyph_bitmap/dsc` */
#if LV_VERSION_CHECK(8, 2, 0) || LVGL_VERSION_MAJOR >= 9
    .fallback = &lv_font_montserrat_16,
#endif
    .user_data = NULL,
};



#endif /*#if HELVETICA10*/
