smartuni/riot-po-2026/nodes/firmware/applications/senseMate/sensemate_ui/helvetica_light_12.c

/*******************************************************************************
 * Size: 12 px
 * Bpp: 1
 * Opts: --bpp 1 --size 12 --no-compress --stride 1 --align 1 --font helvetica-light-587ebe5a59211.ttf --range 32-127 --format lvgl -o helvetica_light_12.c
 ******************************************************************************/

#ifdef __has_include
    #if __has_include("lvgl.h")
        #ifndef LV_LVGL_H_INCLUDE_SIMPLE
            #define LV_LVGL_H_INCLUDE_SIMPLE
        #endif
    #endif
#endif

#ifdef LV_LVGL_H_INCLUDE_SIMPLE
    #include "lvgl.h"
#else
    #include "lvgl/lvgl.h"
#endif



#ifndef HELVETICA_LIGHT_12
#define HELVETICA_LIGHT_12 1
#endif

#if HELVETICA_LIGHT_12

/*-----------------
 *    BITMAPS
 *----------------*/

/*Store the image of the glyphs*/
static LV_ATTRIBUTE_LARGE_CONST const uint8_t glyph_bitmap[] = {
    /* U+0020 " " */
    0x0,

    /* U+0021 "!" */
    0xfe, 0x80,

    /* U+0022 "\"" */
    0xfc,

    /* U+0023 "#" */
    0x28, 0xa2, 0x9f, 0x2b, 0xf4, 0x92, 0x50,

    /* U+0024 "$" */
    0x20, 0x87, 0xab, 0xa2, 0x87, 0x89, 0xa6, 0xb7,
    0x88,

    /* U+0025 "%" */
    0x62, 0x4a, 0x25, 0xd, 0x0, 0xb0, 0xa4, 0x52,
    0x49, 0x23, 0x0,

    /* U+0026 "&" */
    0x38, 0x91, 0x21, 0x85, 0x12, 0xa3, 0x46, 0x7a,

    /* U+0027 "'" */
    0xe0,

    /* U+0028 "(" */
    0x49, 0x49, 0x24, 0x89, 0x20,

    /* U+0029 ")" */
    0x89, 0x12, 0x49, 0x29, 0x40,

    /* U+002A "*" */
    0x27, 0xd8, 0x20,

    /* U+002B "+" */
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

    /* U+006E "n" */
    0xb6, 0x63, 0x18, 0xc6, 0x20,

    /* U+006F "o" */
    0x7b, 0x38, 0x61, 0x87, 0x37, 0x80,

    /* U+0070 "p" */
    0xbb, 0x38, 0x61, 0x87, 0x3b, 0xa0, 0x82, 0x0,

    /* U+0071 "q" */
    0x77, 0x38, 0x61, 0x87, 0x37, 0x41, 0x4, 0x10,

    /* U+0072 "r" */
    0xba, 0x49, 0x20,

    /* U+0073 "s" */
    0x74, 0x60, 0xe0, 0xc5, 0xc0,

    /* U+0074 "t" */
    0x4b, 0xa4, 0x92, 0x60,

    /* U+0075 "u" */
    0x8c, 0x63, 0x18, 0xcd, 0xa0,

    /* U+0076 "v" */
    0x86, 0x24, 0x92, 0x30, 0xc3, 0x0,

    /* U+0077 "w" */
    0x89, 0x89, 0x59, 0x56, 0x56, 0x66, 0x22,

    /* U+0078 "x" */
    0x49, 0x23, 0x4, 0x31, 0x28, 0x80,

    /* U+0079 "y" */
    0x85, 0x24, 0x92, 0x30, 0xc3, 0x8, 0x21, 0x0,

    /* U+007A "z" */
    0xf8, 0x44, 0x44, 0x43, 0xe0,

    /* U+007B "{" */
    0x49, 0x24, 0x92, 0x49, 0x20,

    /* U+007C "|" */
    0xff, 0xf8,

    /* U+007D "}" */
    0x49, 0x24, 0x92, 0x49, 0x20,

    /* U+007E "~" */
    0x66, 0x60
};


/*---------------------
 *  GLYPH DESCRIPTION
 *--------------------*/

static const lv_font_fmt_txt_glyph_dsc_t glyph_dsc[] = {
    {.bitmap_index = 0, .adv_w = 0, .box_w = 0, .box_h = 0, .ofs_x = 0, .ofs_y = 0} /* id = 0 reserved */,
    {.bitmap_index = 0, .adv_w = 53, .box_w = 1, .box_h = 1, .ofs_x = 0, .ofs_y = 0},
    {.bitmap_index = 1, .adv_w = 64, .box_w = 1, .box_h = 9, .ofs_x = 2, .ofs_y = 0},
    {.bitmap_index = 3, .adv_w = 53, .box_w = 2, .box_h = 3, .ofs_x = 1, .ofs_y = 6},
    {.bitmap_index = 4, .adv_w = 107, .box_w = 6, .box_h = 9, .ofs_x = 0, .ofs_y = 0},
    {.bitmap_index = 11, .adv_w = 107, .box_w = 6, .box_h = 12, .ofs_x = 1, .ofs_y = -1},
    {.bitmap_index = 20, .adv_w = 171, .box_w = 9, .box_h = 9, .ofs_x = 1, .ofs_y = 0},
    {.bitmap_index = 31, .adv_w = 128, .box_w = 7, .box_h = 9, .ofs_x = 1, .ofs_y = 0},
    {.bitmap_index = 39, .adv_w = 43, .box_w = 1, .box_h = 3, .ofs_x = 1, .ofs_y = 6},
    {.bitmap_index = 40, .adv_w = 64, .box_w = 3, .box_h = 12, .ofs_x = 1, .ofs_y = -3},
    {.bitmap_index = 45, .adv_w = 64, .box_w = 3, .box_h = 12, .ofs_x = 0, .ofs_y = -3},
    {.bitmap_index = 50, .adv_w = 75, .box_w = 5, .box_h = 4, .ofs_x = 0, .ofs_y = 5},
    {.bitmap_index = 53, .adv_w = 127, .box_w = 7, .box_h = 7, .ofs_x = 1, .ofs_y = 0},
    {.bitmap_index = 60, .adv_w = 53, .box_w = 1, .box_h = 3, .ofs_x = 1, .ofs_y = -2},
    {.bitmap_index = 61, .adv_w = 64, .box_w = 4, .box_h = 1, .ofs_x = 0, .ofs_y = 3},
    {.bitmap_index = 62, .adv_w = 53, .box_w = 1, .box_h = 1, .ofs_x = 1, .ofs_y = 0},
    {.bitmap_index = 63, .adv_w = 53, .box_w = 3, .box_h = 11, .ofs_x = 0, .ofs_y = -2},
    {.bitmap_index = 68, .adv_w = 107, .box_w = 6, .box_h = 9, .ofs_x = 1, .ofs_y = 0},
    {.bitmap_index = 75, .adv_w = 107, .box_w = 3, .box_h = 9, .ofs_x = 2, .ofs_y = 0},
    {.bitmap_index = 79, .adv_w = 107, .box_w = 5, .box_h = 9, .ofs_x = 1, .ofs_y = 0},
    {.bitmap_index = 85, .adv_w = 107, .box_w = 6, .box_h = 9, .ofs_x = 1, .ofs_y = 0},
    {.bitmap_index = 92, .adv_w = 107, .box_w = 6, .box_h = 9, .ofs_x = 1, .ofs_y = 0},
    {.bitmap_index = 99, .adv_w = 107, .box_w = 6, .box_h = 9, .ofs_x = 0, .ofs_y = 0},
    {.bitmap_index = 106, .adv_w = 107, .box_w = 6, .box_h = 9, .ofs_x = 1, .ofs_y = 0},
    {.bitmap_index = 113, .adv_w = 107, .box_w = 6, .box_h = 9, .ofs_x = 1, .ofs_y = 0},
    {.bitmap_index = 120, .adv_w = 107, .box_w = 6, .box_h = 9, .ofs_x = 1, .ofs_y = 0},
    {.bitmap_index = 127, .adv_w = 107, .box_w = 6, .box_h = 9, .ofs_x = 1, .ofs_y = 0},
    {.bitmap_index = 134, .adv_w = 53, .box_w = 1, .box_h = 6, .ofs_x = 1, .ofs_y = 0},
    {.bitmap_index = 135, .adv_w = 53, .box_w = 1, .box_h = 8, .ofs_x = 1, .ofs_y = -2},
    {.bitmap_index = 136, .adv_w = 127, .box_w = 6, .box_h = 7, .ofs_x = 1, .ofs_y = 0},
    {.bitmap_index = 142, .adv_w = 127, .box_w = 6, .box_h = 3, .ofs_x = 1, .ofs_y = 2},
    {.bitmap_index = 145, .adv_w = 127, .box_w = 6, .box_h = 7, .ofs_x = 1, .ofs_y = 0},
    {.bitmap_index = 151, .adv_w = 96, .box_w = 5, .box_h = 9, .ofs_x = 1, .ofs_y = 0},
    {.bitmap_index = 157, .adv_w = 154, .box_w = 9, .box_h = 9, .ofs_x = 1, .ofs_y = 0},
    {.bitmap_index = 168, .adv_w = 128, .box_w = 8, .box_h = 9, .ofs_x = 0, .ofs_y = 0},
    {.bitmap_index = 177, .adv_w = 128, .box_w = 6, .box_h = 9, .ofs_x = 1, .ofs_y = 0},
    {.bitmap_index = 184, .adv_w = 139, .box_w = 8, .box_h = 9, .ofs_x = 1, .ofs_y = 0},
    {.bitmap_index = 193, .adv_w = 139, .box_w = 7, .box_h = 9, .ofs_x = 1, .ofs_y = 0},
    {.bitmap_index = 201, .adv_w = 117, .box_w = 6, .box_h = 9, .ofs_x = 1, .ofs_y = 0},
    {.bitmap_index = 208, .adv_w = 107, .box_w = 6, .box_h = 9, .ofs_x = 1, .ofs_y = 0},
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
    {.bitmap_index = 509, .adv_w = 96, .box_w = 6, .box_h = 7, .ofs_x = 0, .ofs_y = 0},
    {.bitmap_index = 515, .adv_w = 139, .box_w = 8, .box_h = 7, .ofs_x = 0, .ofs_y = 0},
    {.bitmap_index = 522, .adv_w = 96, .box_w = 6, .box_h = 7, .ofs_x = 0, .ofs_y = 0},
    {.bitmap_index = 528, .adv_w = 96, .box_w = 6, .box_h = 10, .ofs_x = 0, .ofs_y = -3},
    {.bitmap_index = 536, .adv_w = 96, .box_w = 5, .box_h = 7, .ofs_x = 1, .ofs_y = 0},
    {.bitmap_index = 541, .adv_w = 64, .box_w = 3, .box_h = 12, .ofs_x = 1, .ofs_y = -3},
    {.bitmap_index = 546, .adv_w = 43, .box_w = 1, .box_h = 13, .ofs_x = 1, .ofs_y = -3},
    {.bitmap_index = 548, .adv_w = 64, .box_w = 3, .box_h = 12, .ofs_x = 1, .ofs_y = -3},
    {.bitmap_index = 553, .adv_w = 127, .box_w = 6, .box_h = 2, .ofs_x = 1, .ofs_y = 2}
};

/*---------------------
 *  CHARACTER MAPPING
 *--------------------*/



/*Collect the unicode lists and glyph_id offsets*/
static const lv_font_fmt_txt_cmap_t cmaps[] =
{
    {
        .range_start = 32, .range_length = 95, .glyph_id_start = 1,
        .unicode_list = NULL, .glyph_id_ofs_list = NULL, .list_length = 0, .type = LV_FONT_FMT_TXT_CMAP_FORMAT0_TINY
    }
};

/*-----------------
 *    KERNING
 *----------------*/


/*Pair left and right glyphs for kerning*/
static const uint8_t kern_pair_glyph_ids[] =
{
    34, 53,
    34, 55,
    34, 56,
    34, 58,
    34, 87,
    34, 88,
    34, 90,
    39, 13,
    39, 15,
    39, 34,
    45, 53,
    45, 55,
    45, 56,
    45, 58,
    45, 90,
    49, 13,
    49, 15,
    49, 34,
    51, 53,
    51, 55,
    51, 56,
    51, 58,
    53, 13,
    53, 14,
    53, 15,
    53, 27,
    53, 28,
    53, 34,
    53, 66,
    53, 68,
    53, 70,
    53, 80,
    53, 83,
    53, 84,
    53, 86,
    53, 88,
    53, 90,
    55, 13,
    55, 14,
    55, 15,
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
};

/* Kerning between the respective left and right glyphs
 * 4.4 format which needs to scaled with `kern_scale`*/
static const int8_t kern_pair_values[] =
{
    -18, -14, -7, -14, -3, -3, -3, -25,
    -25, -11, -18, -18, -11, -21, -7, -25,
    -25, -14, -3, -3, -3, -7, -21, -25,
    -21, -21, -21, -18, -21, -21, -21, -21,
    -18, -21, -18, -16, -16, -25, -11, -25,
    -14, -14, -14, -11, -11, -3, -11, -7,
    -7, -3, -14, -14, -3, -3, -7, -7,
    -3, -3, -3, -3, -21, -21, -21, -18,
    -18, -14, -18, -18, -4, -18, -7, -18,
    -7, -8, -3, -18, -11, -18, -3, -3,
    -3, 3, 3, 3, -3, -3, 3, 3,
    -14, -14, -11, -11, -18, -18
};

/*Collect the kern pair's data in one place*/
static const lv_font_fmt_txt_kern_pair_t kern_pairs =
{
    .glyph_ids = kern_pair_glyph_ids,
    .values = kern_pair_values,
    .pair_cnt = 94,
    .glyph_ids_size = 0
};

/*--------------------
 *  ALL CUSTOM DATA
 *--------------------*/

#if LVGL_VERSION_MAJOR == 8
/*Store all the custom data of the font*/
static  lv_font_fmt_txt_glyph_cache_t cache;
#endif

#if LVGL_VERSION_MAJOR >= 8
static const lv_font_fmt_txt_dsc_t font_dsc = {
#else
static lv_font_fmt_txt_dsc_t font_dsc = {
#endif
    .glyph_bitmap = glyph_bitmap,
    .glyph_dsc = glyph_dsc,
    .cmaps = cmaps,
    .kern_dsc = &kern_pairs,
    .kern_scale = 16,
    .cmap_num = 1,
    .bpp = 1,
    .kern_classes = 0,
    .bitmap_format = 0,
#if LVGL_VERSION_MAJOR == 8
    .cache = &cache
#endif

};



/*-----------------
 *  PUBLIC FONT
 *----------------*/

/*Initialize a public general font descriptor*/
#if LVGL_VERSION_MAJOR >= 8
const lv_font_t helvetica_light_12 = {
#else
lv_font_t helvetica_light_12 = {
#endif
    .get_glyph_dsc = lv_font_get_glyph_dsc_fmt_txt,    /*Function pointer to get glyph's data*/
    .get_glyph_bitmap = lv_font_get_bitmap_fmt_txt,    /*Function pointer to get glyph's bitmap*/
    .line_height = 14,          /*The maximum line height required by the font*/
    .base_line = 3,             /*Baseline measured from the bottom of the line*/
#if !(LVGL_VERSION_MAJOR == 6 && LVGL_VERSION_MINOR == 0)
    .subpx = LV_FONT_SUBPX_NONE,
#endif
#if LV_VERSION_CHECK(7, 4, 0) || LVGL_VERSION_MAJOR >= 8
    .underline_position = -1,
    .underline_thickness = 1,
#endif
    .dsc = &font_dsc,          /*The custom font data. Will be accessed by `get_glyph_bitmap/dsc` */
#if LV_VERSION_CHECK(8, 2, 0) || LVGL_VERSION_MAJOR >= 9
    .fallback = &lv_font_montserrat_12,
#endif
    .user_data = NULL,
};



#endif /*#if HELVETICA_LIGHT_12*/
