smartuni/riot-po-2026/nodes/firmware/applications/senseMate/sensemate_ui/gate_icon_32x32.c

#ifdef __has_include
    #if __has_include("lvgl.h")
        #ifndef LV_LVGL_H_INCLUDE_SIMPLE
            #define LV_LVGL_H_INCLUDE_SIMPLE
        #endif
    #endif
#endif

#if defined(LV_LVGL_H_INCLUDE_SIMPLE)
    #include "lvgl.h"
#else
    #include "lvgl/lvgl.h"
#endif


#ifndef LV_ATTRIBUTE_MEM_ALIGN
#define LV_ATTRIBUTE_MEM_ALIGN
#endif

#ifndef LV_ATTRIBUTE_IMG_GATE_ICON_32X32
#define LV_ATTRIBUTE_IMG_GATE_ICON_32X32
#endif

const LV_ATTRIBUTE_MEM_ALIGN LV_ATTRIBUTE_LARGE_CONST LV_ATTRIBUTE_IMG_GATE_ICON_32X32 uint8_t gate_icon_32x32_map[] = {
  0xff, 0xff, 0xff, 0xff, 	/*Color of index 0*/
  0x00, 0x00, 0x00, 0x04, 	/*Color of index 1*/

  0x87, 0xff, 0xff, 0xe1, 
  0x03, 0xff, 0xff, 0xc0, 
  0x33, 0xff, 0xff, 0xcc, 
  0x30, 0x00, 0x00, 0x0c, 
  0x30, 0x00, 0x00, 0x0c, 
  0x33, 0xe7, 0xe7, 0xcc, 
  0x33, 0xe7, 0xe7, 0xcc, 
  0x33, 0xe7, 0xe7, 0xcc, 
  0x33, 0xe7, 0xe7, 0xcc, 
  0x33, 0xe7, 0xe7, 0xcc, 
  0x33, 0xe7, 0xe7, 0xcc, 
  0x32, 0x00, 0x00, 0x4c, 
  0x30, 0x00, 0x00, 0x0c, 
  0x33, 0xe7, 0xe7, 0xcc, 
  0x33, 0xe7, 0xe7, 0xcc, 
  0x33, 0xe7, 0xe7, 0xcc, 
  0x33, 0xe7, 0xe7, 0xcc, 
  0x33, 0xe7, 0xe7, 0xcc, 
  0x33, 0xe7, 0xe7, 0xcc, 
  0x33, 0xe7, 0xe7, 0xcc, 
  0x32, 0x00, 0x00, 0x4c, 
  0x30, 0x00, 0x00, 0x0c, 
  0x33, 0xe7, 0xe7, 0xcc, 
  0x33, 0xe7, 0xe7, 0xcc, 
  0x33, 0xe7, 0xe7, 0xcc, 
  0x33, 0xe7, 0xe7, 0xcc, 
  0x33, 0xe7, 0xe7, 0xcc, 
  0x33, 0xe7, 0xe7, 0xcc, 
  0x33, 0xf7, 0xef, 0xcc, 
  0x30, 0x00, 0x00, 0x0c, 
  0x00, 0x00, 0x00, 0x00, 
  0x03, 0xff, 0xff, 0xc0, 
};

const lv_img_dsc_t gate_icon_32x32 = {
  .header.cf = LV_IMG_CF_INDEXED_1BIT,
  .header.always_zero = 0,
  .header.reserved = 0,
  .header.w = 32,
  .header.h = 32,
  .data_size = 136,
  .data = gate_icon_32x32_map,
};
