smartuni/riot-po-2026/nodes/firmware/applications/senseMate/sensemate_ui/person_icon_32x32.c

#ifdef __has_include
    #if __has_include("lvgl.h")
        #ifndef LV_LVGL_H_INCLUDE_SIMPLE
            #define LV_LVGL_H_INCLUDE_SIMPLE
        #endif
    #endif
#endif

#if defined(LV_LVGL_H_INCLUDE_SIMPLE)
    #include "lvgl.h"
#else
    #include "lvgl/lvgl.h"
#endif


#ifndef LV_ATTRIBUTE_MEM_ALIGN
#define LV_ATTRIBUTE_MEM_ALIGN
#endif

#ifndef LV_ATTRIBUTE_IMG_PERSON_ICON_32X32
#define LV_ATTRIBUTE_IMG_PERSON_ICON_32X32
#endif

const LV_ATTRIBUTE_MEM_ALIGN LV_ATTRIBUTE_LARGE_CONST LV_ATTRIBUTE_IMG_PERSON_ICON_32X32 uint8_t person_icon_32x32_map[] = {
  0x00, 0x00, 0x00, 0x00, 	/*Color of index 0*/
  0xfe, 0xfe, 0xfe, 0xed, 	/*Color of index 1*/

  0x00, 0x03, 0xe0, 0x00, 
  0x00, 0x1f, 0xf8, 0x00, 
  0x00, 0x3f, 0xfe, 0x00, 
  0x00, 0x3f, 0xfe, 0x00, 
  0x00, 0x7f, 0xff, 0x00, 
  0x00, 0x7f, 0xff, 0x00, 
  0x00, 0x7f, 0xff, 0x00, 
  0x00, 0x7f, 0xff, 0x00, 
  0x00, 0x7f, 0xff, 0x00, 
  0x00, 0x7f, 0xff, 0x00, 
  0x00, 0xff, 0xff, 0x80, 
  0x00, 0xff, 0xff, 0x80, 
  0x00, 0xff, 0xff, 0x80, 
  0x00, 0xff, 0xff, 0x80, 
  0x00, 0x7f, 0xff, 0x00, 
  0x00, 0x7f, 0xff, 0x00, 
  0x00, 0x7f, 0xfe, 0x00, 
  0x00, 0x3f, 0xfe, 0x00, 
  0x00, 0x3f, 0xfc, 0x00, 
  0x00, 0x1f, 0xfc, 0x00, 
  0x00, 0x1f, 0xfc, 0x00, 
  0x00, 0x3f, 0xfe, 0x00, 
  0x00, 0x7f, 0xff, 0x00, 
  0x01, 0xff, 0xff, 0xe0, 
  0x07, 0xff, 0xff, 0xf8, 
  0x3f, 0xff, 0xff, 0xfe, 
  0xff, 0xff, 0xff, 0xff, 
  0xff, 0xff, 0xff, 0xff, 
  0xff, 0xff, 0xff, 0xff, 
  0xff, 0xff, 0xff, 0xff, 
  0xff, 0xff, 0xff, 0xff, 
  0xff, 0xff, 0xff, 0xff, 
};

const lv_img_dsc_t person_icon_32x32 = {
  .header.cf = LV_IMG_CF_INDEXED_1BIT,
  .header.always_zero = 0,
  .header.reserved = 0,
  .header.w = 32,
  .header.h = 32,
  .data_size = 136,
  .data = person_icon_32x32_map,
};
