smartuni/riot-po-2026/nodes/firmware/applications/senseMate/sensemate_ui/tasks_icon_25x32.c

#ifdef __has_include
    #if __has_include("lvgl.h")
        #ifndef LV_LVGL_H_INCLUDE_SIMPLE
            #define LV_LVGL_H_INCLUDE_SIMPLE
        #endif
    #endif
#endif

#if defined(LV_LVGL_H_INCLUDE_SIMPLE)
    #include "lvgl.h"
#else
    #include "lvgl/lvgl.h"
#endif


#ifndef LV_ATTRIBUTE_MEM_ALIGN
#define LV_ATTRIBUTE_MEM_ALIGN
#endif

#ifndef LV_ATTRIBUTE_IMG_TASKS_ICON_25X32
#define LV_ATTRIBUTE_IMG_TASKS_ICON_25X32
#endif

const LV_ATTRIBUTE_MEM_ALIGN LV_ATTRIBUTE_LARGE_CONST LV_ATTRIBUTE_IMG_TASKS_ICON_25X32 uint8_t tasks_icon_25x32_map[] = {
  0x00, 0x00, 0x00, 0x00, 	/*Color of index 0*/
  0xfe, 0xfe, 0xfe, 0x97, 	/*Color of index 1*/

  0x00, 0xff, 0x80, 0x00, 
  0x00, 0xff, 0x80, 0x00, 
  0x07, 0xc1, 0xf0, 0x00, 
  0xff, 0xc1, 0xff, 0x80, 
  0xfe, 0x00, 0x3f, 0x80, 
  0xc6, 0x00, 0x31, 0x80, 
  0xc7, 0xff, 0xf1, 0x80, 
  0xc7, 0xff, 0xf1, 0x80, 
  0xc0, 0x00, 0x01, 0x80, 
  0xc0, 0x00, 0x01, 0x80, 
  0xc0, 0x00, 0x01, 0x80, 
  0xc1, 0x80, 0x01, 0x80, 
  0xcf, 0xbf, 0xf9, 0x80, 
  0xcf, 0x3f, 0xf9, 0x80, 
  0xc6, 0x00, 0x01, 0x80, 
  0xc0, 0x00, 0x01, 0x80, 
  0xc0, 0x00, 0x01, 0x80, 
  0xcf, 0x00, 0x01, 0x80, 
  0xcf, 0x3f, 0xf9, 0x80, 
  0xcf, 0x3f, 0xf9, 0x80, 
  0xcf, 0x00, 0x01, 0x80, 
  0xc0, 0x00, 0x01, 0x80, 
  0xc0, 0x00, 0x01, 0x80, 
  0xc1, 0x80, 0x01, 0x80, 
  0xcf, 0xbf, 0xf9, 0x80, 
  0xcf, 0x3f, 0xf9, 0x80, 
  0xc6, 0x00, 0x01, 0x80, 
  0xc0, 0x00, 0x01, 0x80, 
  0xc0, 0x00, 0x01, 0x80, 
  0xc0, 0x00, 0x01, 0x80, 
  0xff, 0xff, 0xff, 0x80, 
  0xff, 0xff, 0xff, 0x80, 
};

const lv_img_dsc_t tasks_icon_25x32 = {
  .header.cf = LV_IMG_CF_INDEXED_1BIT,
  .header.always_zero = 0,
  .header.reserved = 0,
  .header.w = 25,
  .header.h = 32,
  .data_size = 136,
  .data = tasks_icon_25x32_map,
};
