smartuni/riot-po-2026/(commit log)

2025-08-27 nodes/firmware/senseGate: fix deprecated board name
2025-09-24 nodes/firmware: use define with speaking name for device type selection
2025-09-25 firmware: improve device type and id configuration via Makefile
2025-09-25 firmware/custom-modules/mate_ble: improve prints, make less verbose
2025-09-25 firmware/custom-modules/mate_lorawan: print pkg size
2025-09-25 firmware/gate: fix initial state insertion
    [main.c]
2025-09-25 firmware/sensemate/soundModule: dont vibrate on startup
    [soundModule.c]
2025-09-25 firmware/custom-modules/tables: improve readability of table print
2025-09-30 server/backend: add logic for state confirmation and improve behavior on state updates
    store and handle local and gate timestamps separately. Only update the gate state based on the sensor reading (avoid oscillations due to reports), only add events for new seen reports.
2025-09-30 firmware/senseGate: improve gate debounce logic, reduce debounce time
    add sleep on startup (replaces sleeps in mate_lorawan code)
    [main.c]
2025-10-07 server/backend: introduce different activity types and replace the hacky filter for sensemate reports
2025-10-13 nodes/firmware/senseMate: move ui to its own thread
2025-10-13 nodes/firmware/senseMate/interrupts: drop handling of thumbwheel inputs (now handled by new UI)
2025-10-15 nodes/firmware/custom_modules/mate_ble: add events to rx thread and tx thread
2025-10-15 nodes/firmware/senseMate/main: adjust to new ble_mate thread params
2025-10-15 nodes/firmware/senseMate/soundModule: use spin instead of sleep and remove prints to reduce glitches
    [soundModule.c]
2025-10-16 nodes/firmware/custom-modules/mate-types: improve strcut member order for less memory holes
2025-10-16 nodes/firmware: fix table entry init to be independent of order
    *also streamline the mate type member naming
    [main.c]
2025-10-16 nodes/firmware/custom-modules-tests/tables-test: adust to new types and names, fix print format
    [main.c]
2025-10-16 nodes/firmware/custom-modules/tables: fix print format
2025-10-17 nodes/firmware/custom-modules/tables: add util method to get combined local info, extend table printing
2025-10-28 nodes/firmware/RIOT: bump to current master
2025-11-07 nodes/hardware/SenseMatePCB: update pcb design and multiple 3D objects to allow for nicer renderings
    [12-Pin Header - Female - 2.54mm.step, 16-Pin Header - Female - 2.54mm.step, 3229 Radio FeatherWing.step, 4516 Feather nRF52840 Sense.step, 4516 Feather nRF52840 Sense_FC_exp.step, 4516_Feather_nRF52840_Sense.step, NAV_SWITCH.STEP, NAV_SWITCH_FC_edit-Part.step]
2025-11-07 nodes/hardware/SenseMatePCB: add freecad source of the edited thumbwheel model
    [NAV_SWITCH_FC_edit.FCStd]
2025-11-12 firmware/applications/senseMate/soundModule: shorten update sounds
    [soundModule.c]
2025-11-12 firmware//custom-modules/tables: replace printfs with LOG_DEBUG, add temporary API for mate seen-states
2025-11-12 firmware/custom-modules/mate_ble: make less verbose (debug instead of print)
2025-11-12 firmware/custom-modules/mate_ble: reduce threshold for RSSI filter
2025-11-12 firmware/custom-modules/mate_lorawan: replace unconditional prints with LOG_DEBUG
2025-11-12 firmware/SenseMate/events_creation: replace unconditional prints with LOG_DEBUG
    [events_creation.c]
2025-11-12 server/backend/GateActivityService: fix wrong conflict/confirmation detection due to wrong gate activity filtering
2025-11-12 nodes/firmware/custom-modules: add simple inductive sensor driver
2025-11-12 firmware/senseGate/detectDoorStatus: adjust pin to deployable box wiring
2025-11-14 nodes/firmware/custom-modules/inductive_sensor: fix power ctl on init
    [inductive_sensor.c]
2025-11-14 firmware/applications/senseGate: integrate gate observer and inductive sensor
2025-11-19 firmware/flashdb_store_service: make iterator param void* use different error codes for each case
2025-11-20 nodes/firmware/tests: switch back to native for test_module_tables and test_module_hlc
2025-11-21 tests/test_module_tables: fix iteration of malloc store
    [store.c, test_iterator.c]
2025-11-21 tests/test_module_tables: fix iterator test
    [test_iterator.c]
2025-11-21 /nodes/firmware: switch over to new table types and update includes
2025-11-21 nodes/firmware/custom-modules/tables: add some debugs, switch to log interface
2025-11-24 nodes/firmware/custom-modules/tables/types: define device type values for use in preprocessor conditions
2025-11-24 nodes/firmware/*: use switch over to new DEVICE_TYPE defines of tables/types.h
2025-11-24 nodes/firmware/applications/senseGate: drop old_tables and replace with new implementation
    [gate_observer.c, gate_observer.h, main.c]
2025-11-24 nodes/firmware/applications/senseGate: update personalization to use device type
2025-11-27 nodes/firmware/applications/senseGate/gate_observe: use medium priority event thread
2025-11-27 nodes/firmware/applications/senseGate: increase stacksizes of event threads
2025-11-27 nodes/firmware/applications/senseGate: add some shell commands for debugging of fs and threads
2025-11-27 nodes/firmware/senseMate/sensemate_ui: improve refresh handling, add debug output, increase thread prio
2025-11-27 nodes/firmware/applications/senseMate: allow printing ps periodically for debugging
2025-11-27 nodes/firmware/applications/senseMate: shorten events_creation thread name
    [events_creation.c]
2025-11-27 nodes/firmware/custom-modules/mate_ble: use record_tostr for printing sent records
2025-11-27 nodes/firmware/applications/senseMate: print gate observation entry on creation
2025-11-27 nodes/firmware/custom-modules/mate_lorawan: reduce interval to 20s, dont print payload array
2025-11-27 nodes/firmware/applications/senseGate: allow compilation without analog sensor
2025-12-01 nodes/firmware/custom-modules/mate_lorawan/mate_lorawan: print tx record as to info log
2025-12-03 nodes/firmware/applications/senseGate: use record tostr instead of manual printing
2025-12-03 nodes/firmware/custom-modules/mate_ble: use thread + msgqueue for sending, define what to send via query
2025-12-03 nodes/firmware/applications/senseGate/gate_observer: use separate local event thread for interrupt offloading
2025-12-03 nodes/firmware/custom-modules/mate_lorawan: reduce thread prio
2025-12-03 nodes/firmware/applications/senseGate: enable lowest and medium event thread explicitly
2025-12-03 nodes/firmware/applications/senseGate: adjust to msg based mate_ble tx, adjust thread priorities
2025-12-03 nodes/firmware/custom-modules/mate_lorawan: use thread/query based tx
2025-12-03 nodes/firmware/custom-modules/mate_lorawan: rename thread function
2025-12-03 nodes/firmware/applications/*: move thread init to mate_ble_init
2025-12-03 nodes/firmware/custom-modules/cbor_serialization: allow simple values and unsigned ints <=255 instead of enforcing simple values.
    The current CBOR encoder of the backend encodes even small byte values as unsigned integers.
    There seems to be no option to enforce this behavior on the encoder side, so this makes the decoder a bit more liberal instead.
2025-12-03 nodes/firmware/custom-modules/mate_lorawan: don't expect signature on downlinks, print RX record
2025-12-04 nodes/firmware/custom-modules/mate_lorawan: move join retries into thread, adapt api to only check for join state, drop dead code, improve logging
2025-12-04 nodes/firmware/custom-modules/mate_ble: put mate encounters
    This currently relies on the advertised name.
    In the future the sender id should be read from the message itself.
2025-12-04 nodes/firmware/custom-modules/tables: add simple shell cmd for printing the current tables state
2025-12-04 nodes/firmware/custom-modules/flashdb_store_service: add lock for service operations
    This seems to fix the flashdb corruption (CRC errors / duplicate entries / dropped entries etc.) which is probably triggered by different threads accessing the service.
    The locking could probably be done in a less restrictive way but the root cause (which specific sequence of operations causes the issue) could not be isolated yet.
2025-12-05 nodes/firmware/custom-modules/mate_ble: fix missing mutex unlock in case of ADV timeout
2025-12-09 nodes/firmware/applications/senseMate: add new sound implementation based on pwm
2025-12-09 nodes/firmware/applications/senseMate: switch to new sound module, drop dead interrupts.c
2026-04-27 feat: #3 add backend dockerfile for spring boot application(only backend rn)
2026-05-11 docs: #23 add docsify documentation site and update README
    Add a full docsify documentation site under docs/ covering
    architecture, authentication, data flow, routing, real-time
    communication, and deployment. Rewrite README.md to reflect
    the current features/ + pages/ + shared/ layout.
    Auth documentation updated to reflect inline cookie-based
    auth (proper auth context planned as issue #9).
2026-05-18 10 decouple data layer with rtk (#50)
    * chore(deps): add @reduxjs/toolkit, remove axios
    * feat(store): create Redux store and wrap App with Provider
    * feat(api): define RTK Query API with all endpoints
    * feat(auth): extract auth reducer to proper Redux slice
    * feat(slices): add gates, activities, notifications, downlink slices
    * feat(ws): create WebSocket middleware with STOMP and reconnection
    * feat(store): wire WS middleware and dispatch APP_START
    * refactor(map): migrate MapView to RTK Query
    * refactor(gates): migrate InfoBoxes to Redux selectors
    * refactor(gates): migrate StatusTablesView, remove polling
    * refactor(components): migrate all components to RTK Query and Redux
    Wav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
2026-05-18 Change PostgreSQL driver scope to compile for integration tests
2026-05-18 fix(db): TEMPORARY — remove Flyway-seeded test users with stale BCrypt hashes
    AuthService@constructor creates test users from application.yml but
    skips if Flyway already seeded them. Flyway hash did not match the
    documented test123/test234 passwords → "Invalid credentials" on login.
    TEMP FIX: removed conflicting INSERT from migration. Working DB fixed
    by manually deleting stale rows so AuthService recreates on restart.
    BACKEND TEAM TODO — single source of truth for test credentials:
    Option A: Keep application.yml as source → AuthService must UPDATE
    password on existing users, not skip them.
    Option B: Keep Flyway as source → hardcoded hashes must match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
2026-05-31 63: create playwright tests (#65)
    * feat: Add backend Playwright API tests and integrate docker backend into CI
    * feat: add deterministic e2e backend setup
    * fix(backend): make CORS allowed origins configurable
    The CORS allow-list was hardcoded to http://localhost:3000 in both
    SecurityConfig (the authoritative source — the Spring Security filter
    runs before MVC) and WebConfig. Browser requests from the Vite/Playwright
    dev server on :5173 were rejected with 403, so all UI-driven e2e tests
    failed at login.
    Both now read app.cors.allowed-origins (default localhost:3000, so prod
    is unchanged). The e2e profile adds localhost:5173.
    * feat(e2e): seed deterministic test users and rebuild on r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
    [AuthService.java, SecurityConfig.java]
2026-06-01 feat(e2e): switch to H2 in-memory database and add CI smoke tests (#69)
    - Replace PostgreSQL + Flyway with H2 in-memory + Hibernate DDL auto
    for self-contained E2E tests (no external DB needed)
    - Add data-e2e.sql seed data for deterministic E2E state
    - Change H2 scope from 'test' to 'runtime' to be available at runtime
    - Update docker-compose.e2e.yml to remove PostgreSQL dependency
    - Update e2e-reset.sh and playwright config for simplified H2 setup
    - Add docker smoke test jobs to GitHub Actions and GitLab CI
    after docker builds to verify full-stack health
2026-06-12 26-created a Version 2 of PCB included LoRa127x1 and nRF52840 SensePlus to Project
    [12-Pin Header - Female - 2.54mm.step, 16-Pin Header - Female - 2.54mm.step, 3229 Radio FeatherWing.step, 4516 Feather nRF52840 Sense.step, 4516 Feather nRF52840 Sense_FC_exp.step, 4516 Feather nRF52840 Sense_FC_exp.stl, 4516_Feather_nRF52840_Sense.step, NAV_SWITCH.STEP]
2026-06-12 Aktualisierung der Verbindungen und Kommentare für offene Verbindungen.
    [SenseMatePCB.kicad_sch]
2026-06-12 26-finished marking used pins
    [SenseMatePCB.kicad_pcb, SenseMatePCB.kicad_sch]
2026-06-12 26-finished all connections from feather carried over
    [SenseMatePCB.kicad_sch]
2026-06-12 26-Finalisierung der Verbindunen zwischen den Geräten und Aufräumen des Schemas
    [SenseMatePCB.kicad_pcb, SenseMatePCB.kicad_sch]
2026-06-12 fehlende 3D symboly für SeedStudio und LoraChip hinzugefügt, Netzte Verbunden, Kommentare ergänzt
    [RFM95 LoRa v15.step, SenseMatePCB.kicad_pcb, SenseMatePCB.kicad_sch, seeeduino-xiao-samd21-v4.step]
2026-06-12 reorganized design of board
    [SenseMatePCB.kicad_pcb, SenseMatePCB.kicad_sch]
2026-06-12 added wireing and copperboard
    [SenseMatePCB.kicad_pcb]
2026-06-12 fixed Errors
    [SenseMatePCB.kicad_pcb]
2026-06-12 redesign parts wip V2.1
    [SenseMatePCB.kicad_pcb]
2026-06-12 pcb version 2.1 done
    [SenseMatePCB.kicad_pcb, SenseMatePCB.kicad_sch]
2026-06-12 sensemate pcb v2.2: optimized routing further
    [SenseMatePCB.kicad_pcb]
2026-06-12 nodes/hardware/PCB: save some space with different arrangement
    [SenseMatePCB.kicad_pcb, SenseMatePCB.kicad_sch]
2026-06-12 finished tracing
    [SenseMatePCB.kicad_pcb, SenseMatePCB.kicad_sch, v2_export.stl]
2026-06-12 castellations almost done
    [SenseMatePCB.kicad_pcb, SenseMatePCB.kicad_sch]
2026-06-12 SENSEMATE V3 DONE
    [SenseMatePCB.kicad_pcb, SenseMatePCB.kicad_sch]
2026-06-12 updated documentation for PIN use in schematic - Thumb and pogoPins
    [SenseMatePCB.kicad_sch]
2026-06-12 Changed SMD Transistor to SS8050 to fix Problem with wrong fields
    [SenseMatePCB.kicad_pcb, SenseMatePCB.kicad_sch]
2026-06-12 added mounting hole
    [SenseMatePCB.kicad_pcb]
2026-06-13 9: feature frontend proper authentication layer (#67)
    * feat(backend): set HttpOnly JWT cookies on login/register, read from cookie in filter
    - AuthController: login/register set HttpOnly ResponseCookie 'jwt' (SameSite=Lax, path=/)
    Secure flag configurable via app.cookie.secure (defaults false for dev)
    - AuthController: logout clears jwt cookie (Max-Age=0), extracts token from cookie or Bearer
    - AuthController: userDetails/changeUserDetails now use HttpServletRequest (cookie-first extraction)
    - JwtAuthenticationFilter: extracts JWT from Cookie header first, falls back to Authorization: Bearer
    - JwtAuthenticationFilter: shouldNotFilter narrowed to exact auth endpoints (login/register/logou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
2026-06-13 pass power to outside with castellation and some minor tweaks to traces
    [SenseMatePCB.kicad_pcb, SenseMatePCB.kicad_sch]
2026-06-13 minor tweaks to trace routing and passing power stuff to castellations
    [SenseMatePCB.kicad_pcb, SenseMatePCB.kicad_sch]
2026-06-14 created footprint of sensemate pcb
2026-06-14 nodes/firmware/RIOT: changed branch of submodule to XIAOSenseMate-pwmFeatures
2026-06-14 nodes/firmware: tried to clean drc errors and warnings
    [SenseMatePCB.kicad_pcb, v2_export.stl]
2026-06-15 13 feature translate yml (#94)
    * hardware pipeline Übersetzung von gitlab zu github
    * Option hinzugefügt, um bei fehlender Hardware Tests zu deaktivieren
    * USB angepasst
    * Hardware Tests aktivieren für Test-Branch
    * Fix Hardware-Tests Docker
    * Fix Hardware-Tests Docker
    * Add Board Helper
    * final github pipeline
    ---------
2026-06-15 19 feature sensemate code cleanup (#45)
    * Todo 1: add sensor timestamp to gate report
    * todo 2: replace node id lookup hack with
    proper function
    * todo 2
    * Implement pending jobs tracking and rssi minimum for visible mates
    * Improve code pattern
    * removed magic number for min rssi
    [main.c, sensemate_ui.c, sensemate_ui.h]
2026-06-15 hardware/SenseMate_v2: Finished Design and created gerber files
    [SenseMatePCB-B_Cu.gbl, SenseMatePCB-B_Mask.gbs, SenseMatePCB-B_Paste.gbp, SenseMatePCB-B_SilkS.gbo, SenseMatePCB-B_Silkscreen.gbo, SenseMatePCB-Back.gbl, SenseMatePCB-Edge_Cuts.gm1, SenseMatePCB-F_Cu.gtl]
2026-06-16 hardware/SenseMate_v2: corrected Edge Cuts and created new gerber files
    [SenseMatePCB-B_Mask.gbs, SenseMatePCB-B_Paste.gbp, SenseMatePCB-B_Silkscreen.gbo, SenseMatePCB-Back.gbl, SenseMatePCB-Edge_Cuts.gm1, SenseMatePCB-F_Mask.gts, SenseMatePCB-F_Paste.gtp, SenseMatePCB-F_Silkscreen.gto]
2026-06-18 hardware/SenseMate_v2: added lables to pins, and solved some warnings and errors
    [SenseMatePCB-B_Mask.gbs, SenseMatePCB-B_Paste.gbp, SenseMatePCB-B_Silkscreen.gbo, SenseMatePCB-Back.gbl, SenseMatePCB-Edge_Cuts.gm1, SenseMatePCB-F_Mask.gts, SenseMatePCB-F_Paste.gtp, SenseMatePCB-F_Silkscreen.gto]
2026-06-22 Fix: gate-service WS + restore e2e/WS auth after #67 merge (#95)
    * fix: replace getById() with findById() to avoid Hibernate proxy LazyInitializationException
    GateRepository.getById() returns a Hibernate proxy instead of a fully
    initialized entity. When accessed outside a Hibernate session (e.g. on
    the MQTT client thread), the proxy cannot initialize and throws:
    Could not initialize proxy - no session
    Replace all gateRepository.getById() calls with
    findById().orElseThrow() which eagerly loads the full entity.
    Affected methods:
    - changeGateStatus() (called from MQTT IST_STATE handler)
    - changeGateStateConfirmation() (called from MQTT IST_STATE handler)
    - requestGateStatusC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
    [SecurityConfig.java]
2026-07-02 feat(frontend): Hydro Blue redesign — full UI overhaul (#80)
    * feat(frontend): Hydro Blue redesign — squash of 5 commits
    * feat(frontend): Hydro Blue redesign — squash of 5 commits
    * fix(frontend): dark mode in Redux + sessionStorage, fix title, drop redundant CSS imports
    - Add uiSlice with darkMode state (sessionStorage-backed, falls back to prefers-color-scheme)
    - App.jsx syncs body.classList + sessionStorage from Redux state
    - DarkModeToggle and SettingsPage share single Redux source
    - index.html: title 'React App' → 'SenseMate', add FOUC prevention script
    - Remove redundant theme.css imports from SkeletonLoader and LogsPage
    * fix(frontend): add light sidebar theme variant
    Si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
2026-07-03 feat(frontend): add clickable stat card filtering on dashboard
    Stat cards now act as interactive filter buttons — clicking a card toggles the gate list filter. Filter state is lifted to DashboardPage and passed to both StatCards and table components.
2026-07-03 feat(frontend): polish dialogs with Hydro Blue design system
    ManualStatusDialog: replaces MUI Radio/Alert/Button with custom card selectors and styled divs.
    StatusChangedDialog: same redesign — clickable status buttons, info note, btn classes.
    Both use rgba() backgrounds for dark-mode-safe contrast.
2026-07-03 feat(frontend): replace devices placeholder with gate overview cards
    DevicesPage now shows all gates as cards with status, confidence, height über NN, priority, state confirmation.
    Removes 'Soon' badge from Devices and Gate Control sidebar items.
2026-07-03 fix(e2e): update seed data reference and extend SEEDED_GATES with full H2 fields
    Fix comment reference from V100__e2e_seed.sql (disabled Postgres Flyway) to data-e2e.sql (active H2 in-memory seed). Extend SEEDED_GATES with stateConfirmation, heightAboveNN, priority, confidence, deviceId, and manualOverride fields to match the H2 seed.
2026-07-03 fix(e2e): replace broken map tab test with /map route test and add stat card filtering tests
    The map view/list view tab toggle was removed from the dashboard (commit 3e3b6a9). Replace the broken test that clicked non-existent Map View tabs with a test that navigates to /map directly. Add 4 new tests for the clickable stat card filtering feature: Open filter, toggle clear, Total Gates, and Closed filter.
2026-07-03 test(e2e): add gate detail, automation, and devices page e2e tests
    Add three new e2e test files for new feature pages:
    - gate-detail.spec.ts (10 tests): gate header/info/activities display, back button navigation, controller vs viewer action buttons, height inline edit, priority MUI Select, manual status override dialog, delete gate with confirmation
    - automation.spec.ts (6 tests): water level input + risk assessment (LOW/MEDIUM/CRITICAL), recommended actions per gate, edit mode pre-selection, viewer read-only alert, propose changes mutation with cleanup
    - devices.spec.ts (5 tests): gate overview card grid rendering, card field display (confidence/height/priority/state confirmation/device),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
2026-07-03 fix(e2e): fix stateConfirmation, Activities card locator, and viewer login in CI
    Three CI fixes: (1) Remove hardcoded stateConfirmation labels from devices.spec.ts and gate-detail.spec.ts — the H2 seed does not reliably set state_confirmation values in CI, so assert only the section exists. (2) Fix Activities card locator in gate-detail.spec.ts — .card with hasText 'Activities' matched two cards (Activities card + Quick Stats card with activity count), so scope via .card-header instead. (3) Fix viewer test — beforeEach logs in as CONTROLLER, so calling login(page, VIEWER) without logging out first fails because PublicOnlyRoute redirects to /dashboard.
2026-07-04 fix(frontend): use correct activityType field and enum values
    ActivityPanel and LogsPage read activity.type which doesn't exist — backend sends activityType (Enum: SENSOR_NEW, SENSOR_VALUE_CHANGED, etc.). All activity dots/icons were always blue/fallback, type text showed '—', and type filter never matched.
2026-07-04 fix(frontend): apply bulk status change only to selected gates
    The 'Apply to Filtered' button ignored checkbox selection and applied the action to all filteredGates instead. Now respects selectedGateIds, disables when no gates selected, and clears selection after apply.
2026-07-06 applications/senseMate: Changed GPIO-Pins for Buzzer and Sound
    [main.c, vibrationModule.c]
2026-07-06 feat(firmware): support both board variants and throw an error otherwise
    [main.c, sensemate_ui.c, vibrationModule.c]
2026-07-06 feat(senseGate): support different reed pin for new board
2026-07-09 113: Health status for SenseGate in frontend (#116)
    * Backend implementation for health status
    * update Health Status to new format
    * Health Status update Kommunikation zwischen Hardware und Backend
    * feat(backend): add HealthStatusService with in-memory store and per-field merge
    * feat(backend): add HealthController REST endpoint and e2e health seeder
    * feat(backend): add /e2e/simulate-health endpoint for WS health broadcasts
    * feat(frontend): add healthSlice with per-field merge logic and tests
    * feat(frontend): add HealthBadge component, useHealthForGate hook, and health utils
    * feat(frontend): wire health into Redux store, wsMiddleware, and RTK Query
    * feat(frontend): integrate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
2026-07-09 feat(backend): fully disable CORS for HTTP and WebSocket (#115)
    * feat(backend): disable CORS for all HTTP and WebSocket endpoints
    WebConfig: allow all origins, methods, and headers via allowedOriginPatterns("*"). SecurityConfig: remove corsEnabled flag, unconditionally disable Spring Security CORS. WebSocketConfig: remove allowedOrigins property, use setAllowedOriginPatterns("*") for STOMP handshake.
    Ultraworked with [Sisyphus](https://github.com/code-yeongyu/oh-my-openagent)
    * chore(backend): remove dead CORS properties and stale comments
    application-dev.properties: remove app.cors.enabled (field removed from SecurityConfig). appli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
2026-07-09 58 create sensegate pcb (#112)
    * 26-created a Version 2 of PCB included LoRa127x1 and nRF52840 SensePlus to Project
    * Aktualisierung der Verbindungen und Kommentare für offene Verbindungen.
    * 26-finished marking used pins
    * 26-finished all connections from feather carried over
    * 26-Finalisierung der Verbindunen zwischen den Geräten und Aufräumen des Schemas
    * added Documentation folder
    * fehlende 3D symboly für SeedStudio und LoraChip hinzugefügt, Netzte Verbunden, Kommentare ergänzt
    * reorganized design of board
    * added wireing and copperboard
    * fixed Errors
    * redesign parts wip V2.1
    * pcb version 2.1 done
    * sensemate pcb v2.2: optimized routing further
    * Update SenseMate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
    [sensegate_pcb-B_Cu.gbr, sensegate_pcb-B_Mask.gbr, sensegate_pcb-B_Paste.gbr, sensegate_pcb-B_Silkscreen.gbr, sensegate_pcb-Edge_Cuts.gbr, sensegate_pcb-F_Cu.gbr, sensegate_pcb-F_Mask.gbr, sensegate_pcb-F_Paste.gbr]
2026-07-09 fixed compiler errors because of renamed variables
    [main.c, sensemate_ui.c, sensemate_ui.h]
2026-07-10 feat(identity_store): add print_identity shell command
    Add print_identity shell command for printing an identity from a given
    identity file as a hex encoded byte string.
2026-07-10 feat(sensegate): Remove special inductive sensor config for device id 1
2026-07-10 feat(mate_lorawan): use dynamically provisioned keys from identity store
    Add The Things Network/LoraWAN configuration to the provisioning payload
    and have the LoraWAN interface then use this dynamically provisioned
    configuration.
    Also move The Things Network setup functionality to the
    identity-manager.py to have the configuration be part of the generated
    provisioning payload and delete the now no longer needed key-distro
    module.
    [cbor_serialization.c, identity-manager.py]
2026-07-10 fix gate gpio config
    fix gate gpio config to read the state of the reed sensor properly
    [main.c]
2026-07-12 [NEW] Health monitoring integration stage (#121)
    * Health monitoring
    * removed some commented blocks
    * added error handling
    * removed #pragma, adjusted LOG_DEBUG
    * refined the code comments
    * - added error handling;
    - removed unused running flag
    * removed accidental duplicate includes
    * refactor: replace hardcoded values with defined constants
    * refactor to thread_XXX
    * add health monitor error handling in main
    * removed delete functions
    * removed the comment
    * reverted to LOG_INFO due to compiler error
    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
    [main.c]
2026-07-12 Revert broken state from #121
    This reverts commit f8c75db03cf3d91547d8baae53b4f662180770d7.
    [main.c]
2026-08-14 Update root README to current project state
2026-08-14 ci(firmware-build): provide CI for simply building the firmware
    Provide CI for simply building the firmware for all node and board types
    when pushing to main or creating a PR.
2026-08-14 feat(identity-manager): consider TTN devices when finding free device ID
2026-08-14 refactor(identity-manager): move device id to argument for create cmd
    Move device id to be an argument, instead of an option, as this should
    be more intuitive to use.
